erlerobot/PXF2/Documentation/OdroidC1pinout.png

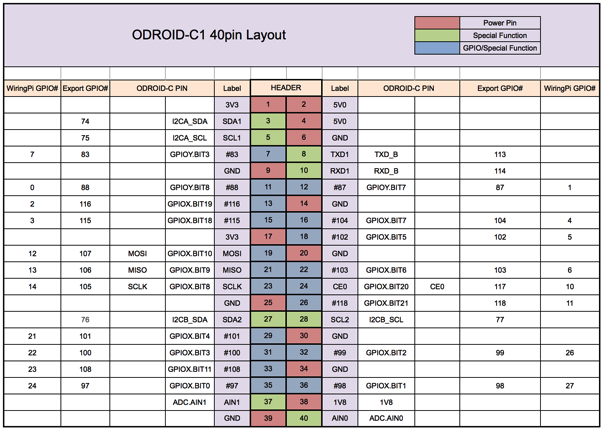
Documentation/OdroidC1pinout.png
