erlerobot/PXF2/Documentation/links.md

HATs intro -> http://www.raspberrypi.org/introducing-raspberry-pi-hats/
