erlerobot/PXF2/Documentation/Rpi2-PXF.png

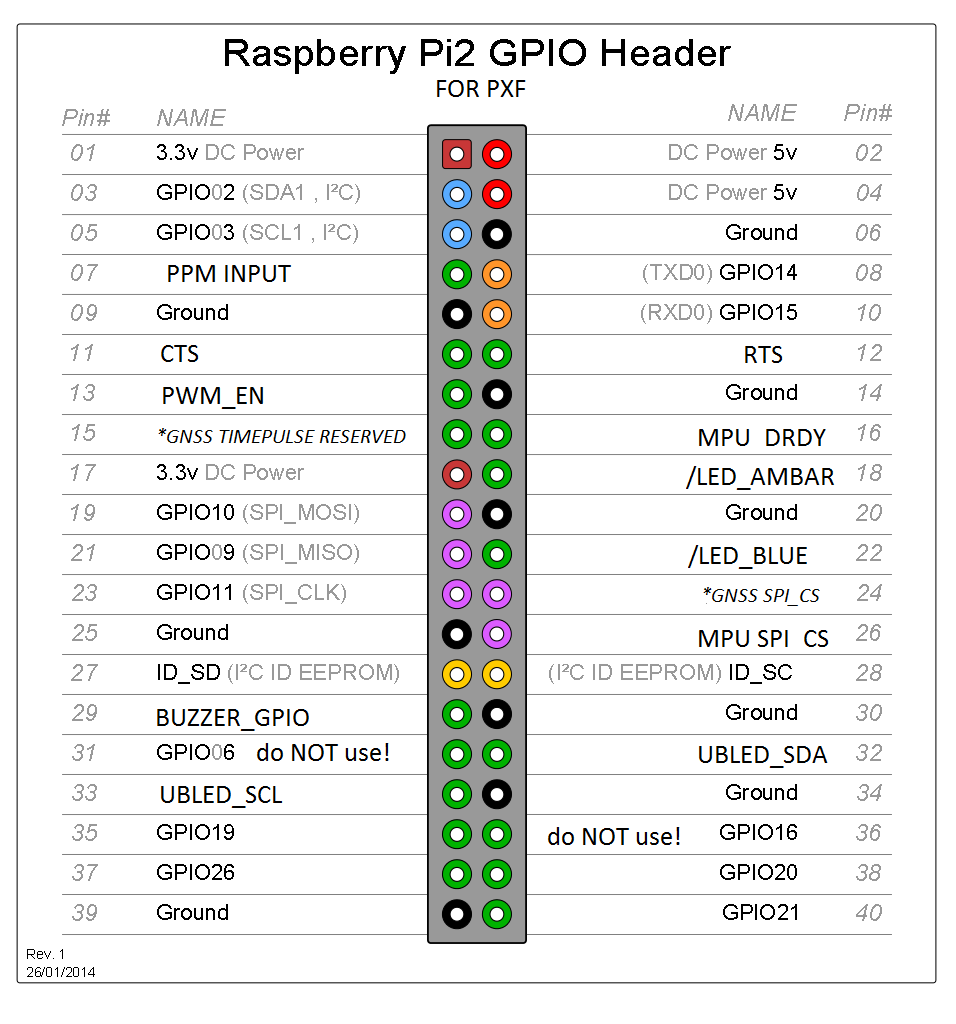
Documentation/Rpi2-PXF.png
