erlerobot/PXF2/(threads)

Thread 1 (2016-01-22):

How big are your hearts I might have found a measurement device.

Irishandfreckled, 2016-01-22:
I'm 35 and for the last 1/3 of my life I was not part of it nor was any Life to be quarryed from the deepest reaches. As a younger man I qualified as a Carpenter. After7 years of magical wood evocation I completed a year long metal multiskils certified "feetac accredited" level 11. I'm sure I don't need to explain to smart well educated souls whereby 10 years evaporated. 2 years ago I promised to never be the victim any longer. I started back rebuilding my workshop, body and mind in that order. Awesome change became a given. I started spending my disposal income on a far healthier hobby. Over the last 18 months I learned in a sort of figure of 8 haha. I started with a mid sized quad w 2 mp to SD.Then I bought similar but made sure it had demolition derby like bumper all round. And 40 spare props. As I research I figure maybe a small cq10 can help along those pilot skills. Boy was it a revelation, a month of daily flying and I had a whole new respect for the game. The bumpers came off and spare parts ordered every battery was a 16th too big to fit internally. Customisation really got the heart racing. I mounted it underneath leaving a perfect spot for a better receiver adding the battery weight on bottom gave it a new co gravity and by pure luck I had a fluck of a flyer
Unbeaten control combined with new found skill and further range,I was hooked all over again since I've built a hex with WiFi fps. Currently I have a goal of building a nano fps, all the design is waiting on the Chinese postal service. Can I ask github for the chance to build some form of multi rotor that has all you need in any situation, be it shows for the collogues or stealing the show at a sister's wedding
Sponsor me with your latest technical technology and techniques and I'll be happy to give my full attention from cad to completed one off. My goal should it happen is a quantum leap inveloped by propellers. Foxyinboston@gmail.com let's take it there together.

Closed 2016-01-23.
