erlerobot/PXF2/PXF_v2.0.brd

## EAGLE design PXF_v2.0.brd (2015-11-10)

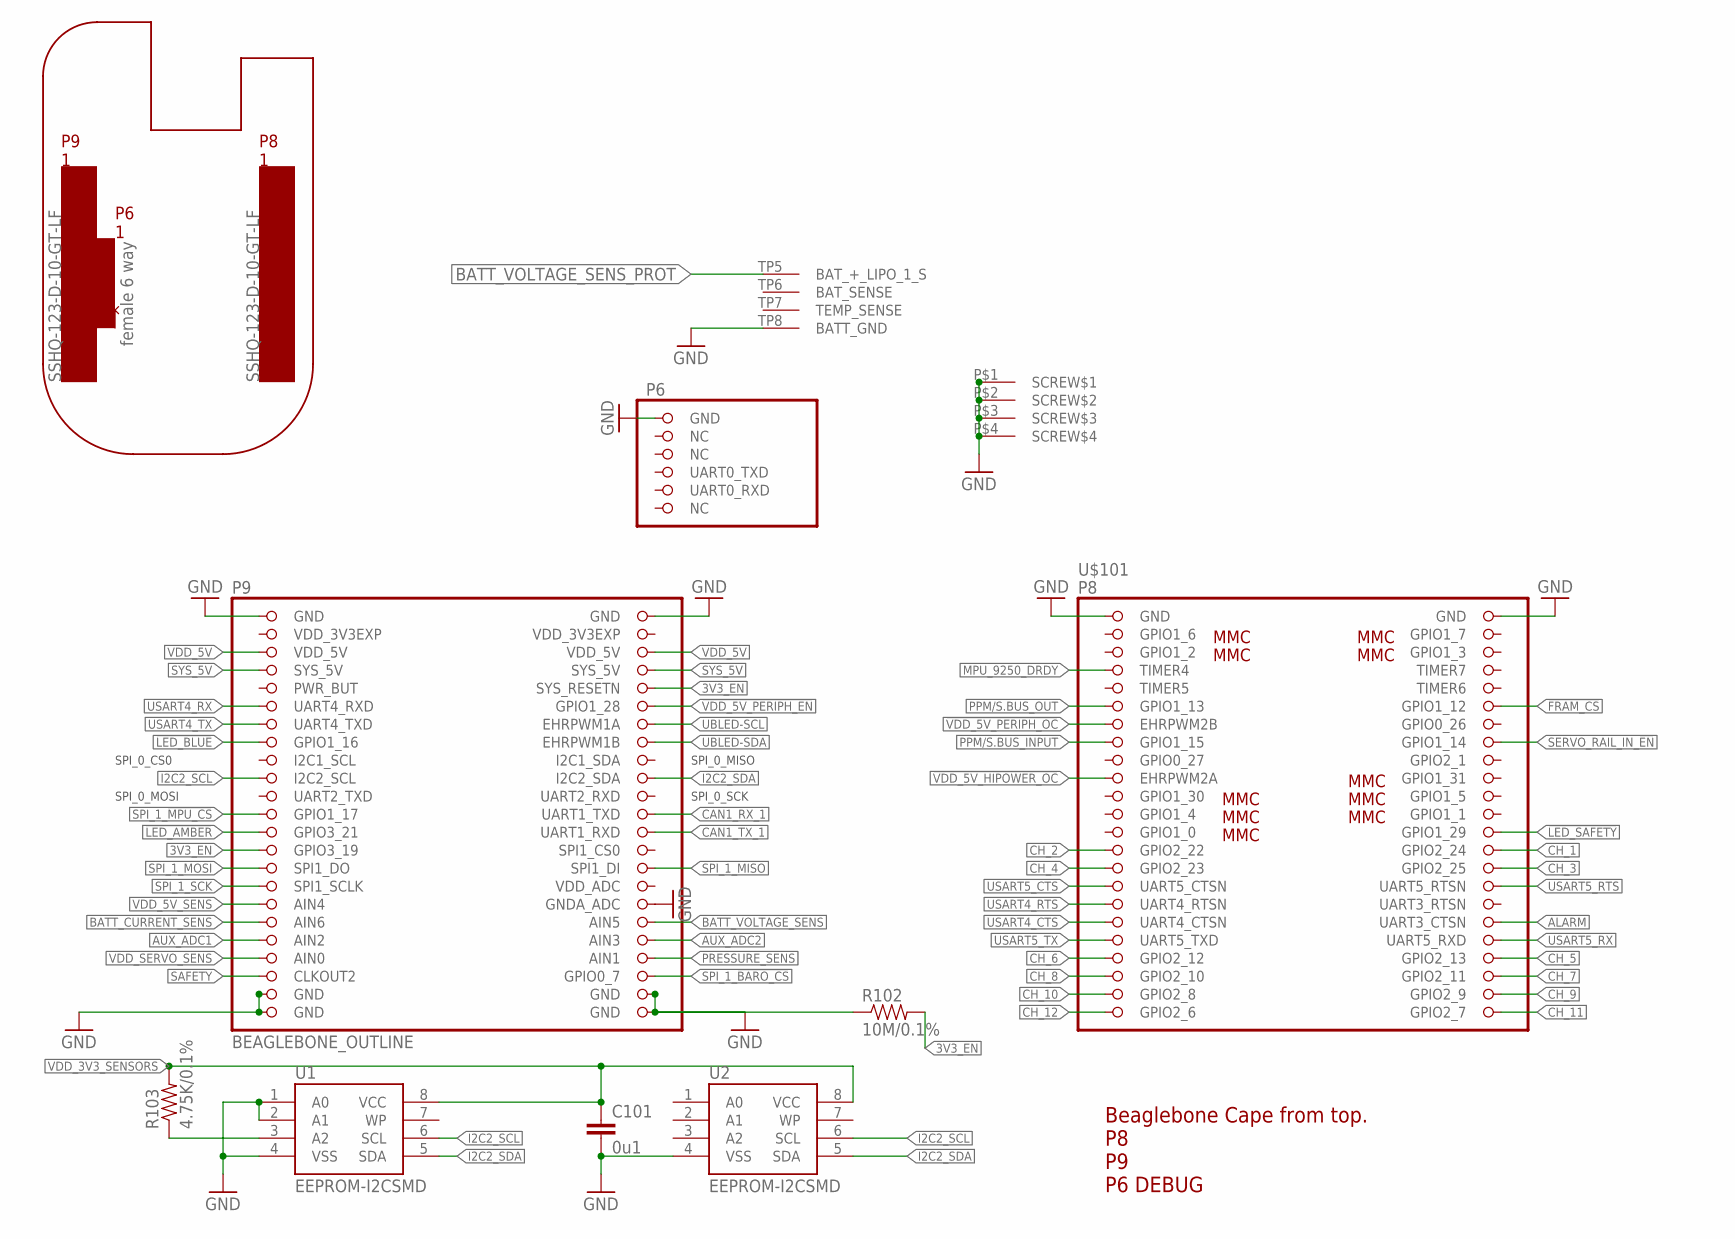
[picture p3: schematic PXF_v2.0.sch, sheet 1]

Parts:
C101: 0u1; 0402-CAP; PARTNO CC0402ZRY5V7BB104
R102: 10M/0.1%; 0402-RES; PARTNO RC0402FR-0710ML
R103: 4.75K/0.1%; 0402-RES; PARTNO RC0402FR-074K75L
U1: EEPROM-I2CSMD; SO08; PARTNO AT24CS32-SSHM
U2: EEPROM-I2CSMD; SO08; PARTNO ATSHA204-SH-DA-TTR-ND
U$101: BEAGLEBONE_OUTLINE; BEAGLEBONE_SHIELD

Connections:
3V3_EN: R102.P$2 (2), U$101.56 (SYS_RESETN), U$101.73 (GPIO3_19); also elsewhere on the board
!FRAM_CS: U$101.12 (GPIO1_12); also elsewhere on the board
!LED_AMBER: U$101.71 (GPIO3_21); also elsewhere on the board
!LED_BLUE: U$101.61 (GPIO1_16); also elsewhere on the board
!LED_SAFETY: U$101.26 (GPIO1_29); also elsewhere on the board
!VDD_5V_HIPOWER_OC: U$101.19 (EHRPWM2A); also elsewhere on the board
!VDD_5V_PERIPH_EN: U$101.58 (GPIO1_28); also elsewhere on the board
!VDD_5V_PERIPH_OC: U$101.13 (EHRPWM2B); also elsewhere on the board
ALARM: U$101.36 (UART3_CTSN); also elsewhere on the board
AUX_ADC1: U$101.83 (AIN2); also elsewhere on the board
AUX_ADC2: U$101.84 (AIN3); also elsewhere on the board
BATT_CURRENT_SENS: U$101.81 (AIN6); also elsewhere on the board
BATT_VOLTAGE_SENS: U$101.82 (AIN5); also elsewhere on the board
BATT_VOLTAGE_SENS_PROT: U$101.TP5 (BAT_+_LIPO_1_S); also elsewhere on the board
CAN1_RX_1: U$101.70 (UART1_TXD); also elsewhere on the board
CAN1_TX_1: U$101.72 (UART1_RXD); also elsewhere on the board
CH_1: U$101.28 (GPIO2_24); also elsewhere on the board
CH_2: U$101.27 (GPIO2_22); also elsewhere on the board
CH_3: U$101.30 (GPIO2_25); also elsewhere on the board
CH_4: U$101.29 (GPIO2_23); also elsewhere on the board
CH_5: U$101.40 (GPIO2_13); also elsewhere on the board
CH_6: U$101.39 (GPIO2_12); also elsewhere on the board
CH_7: U$101.42 (GPIO2_11); also elsewhere on the board
CH_8: U$101.41 (GPIO2_10); also elsewhere on the board
CH_9: U$101.44 (GPIO2_9); also elsewhere on the board
CH_10: U$101.43 (GPIO2_8); also elsewhere on the board
CH_11: U$101.46 (GPIO2_7); also elsewhere on the board
CH_12: U$101.45 (GPIO2_6); also elsewhere on the board
GND: C101.P$2 (2), R102.P$1 (1), U1.1 (A0), U1.2 (A1), U1.4 (VSS), U2.4 (VSS), U$101.1 (GND), U$101.2 (GND), U$101.47 (GND), U$101.48 (GND), U$101.80 (GNDA_ADC), U$101.89 (GND), U$101.90 (GND), U$101.91 (GND), U$101.92 (GND), U$101.93 (GND), U$101.P$1 (SCREW$1), U$101.P$2 (SCREW$2), U$101.P$3 (SCREW$3), U$101.P$4 (SCREW$4), U$101.TP8 (BATT_GND); also elsewhere on the board
I2C2_SCL: U1.6 (SCL), U2.6 (SCL), U$101.65 (I2C2_SCL); also elsewhere on the board
I2C2_SDA: U1.5 (SDA), U2.5 (SDA), U$101.66 (I2C2_SDA); also elsewhere on the board
MPU_9250_DRDY: U$101.7 (TIMER4); also elsewhere on the board
unnamed: R103.P$1 (1), U1.3 (A2)
PPM/S.BUS_INPUT: U$101.15 (GPIO1_15); also elsewhere on the board
PPM/S.BUS_OUT: U$101.11 (GPIO1_13); also elsewhere on the board
PRESSURE_SENS: U$101.86 (AIN1); also elsewhere on the board
SAFETY: U$101.87 (CLKOUT2); also elsewhere on the board
SERVO_RAIL_IN_!EN: U$101.16 (GPIO1_14)
SPI_1_!BARO_CS: U$101.88 (GPIO0_7); also elsewhere on the board
SPI_1_!MPU_CS: U$101.69 (GPIO1_17); also elsewhere on the board
SPI_1_MISO: U$101.76 (SPI1_DI); also elsewhere on the board
SPI_1_MOSI: U$101.75 (SPI1_DO); also elsewhere on the board
SPI_1_SCK: U$101.77 (SPI1_SCLK); also elsewhere on the board
SYS_5V: U$101.53 (SYS_5V), U$101.54 (SYS_5V); also elsewhere on the board
UBLED-SCL: U$101.60 (EHRPWM1A); also elsewhere on the board
UBLED-SDA: U$101.62 (EHRPWM1B); also elsewhere on the board
USART4_CTS: U$101.35 (UART4_CTSN); also elsewhere on the board
USART4_RTS: U$101.33 (UART4_RTSN); also elsewhere on the board
USART4_RX: U$101.57 (UART4_RXD); also elsewhere on the board
USART4_TX: U$101.59 (UART4_TXD); also elsewhere on the board
USART5_CTS: U$101.31 (UART5_CTSN); also elsewhere on the board
USART5_RTS: U$101.32 (UART5_RTSN); also elsewhere on the board
USART5_RX: U$101.38 (UART5_RXD); also elsewhere on the board
USART5_TX: U$101.37 (UART5_TXD); also elsewhere on the board
VDD_3V3EXP: U$101.49 (VDD_3V3EXP), U$101.50 (VDD_3V3EXP)
VDD_3V3_SENSORS: C101.P$1 (1), R103.P$2 (2), U1.8 (VCC), U2.8 (VCC); also elsewhere on the board
VDD_5V: U$101.51 (VDD_5V), U$101.52 (VDD_5V); also elsewhere on the board
VDD_5V_SENS: U$101.79 (AIN4); also elsewhere on the board
VDD_SERVO_SENS: U$101.85 (AIN0); also elsewhere on the board

Notes on the sheet:
Beaglebone Cape from top. P8 P9 P6 DEBUG
SPI_0_CS0
SPI_0_MOSI
SPI_0_MISO
SPI_0_SCK

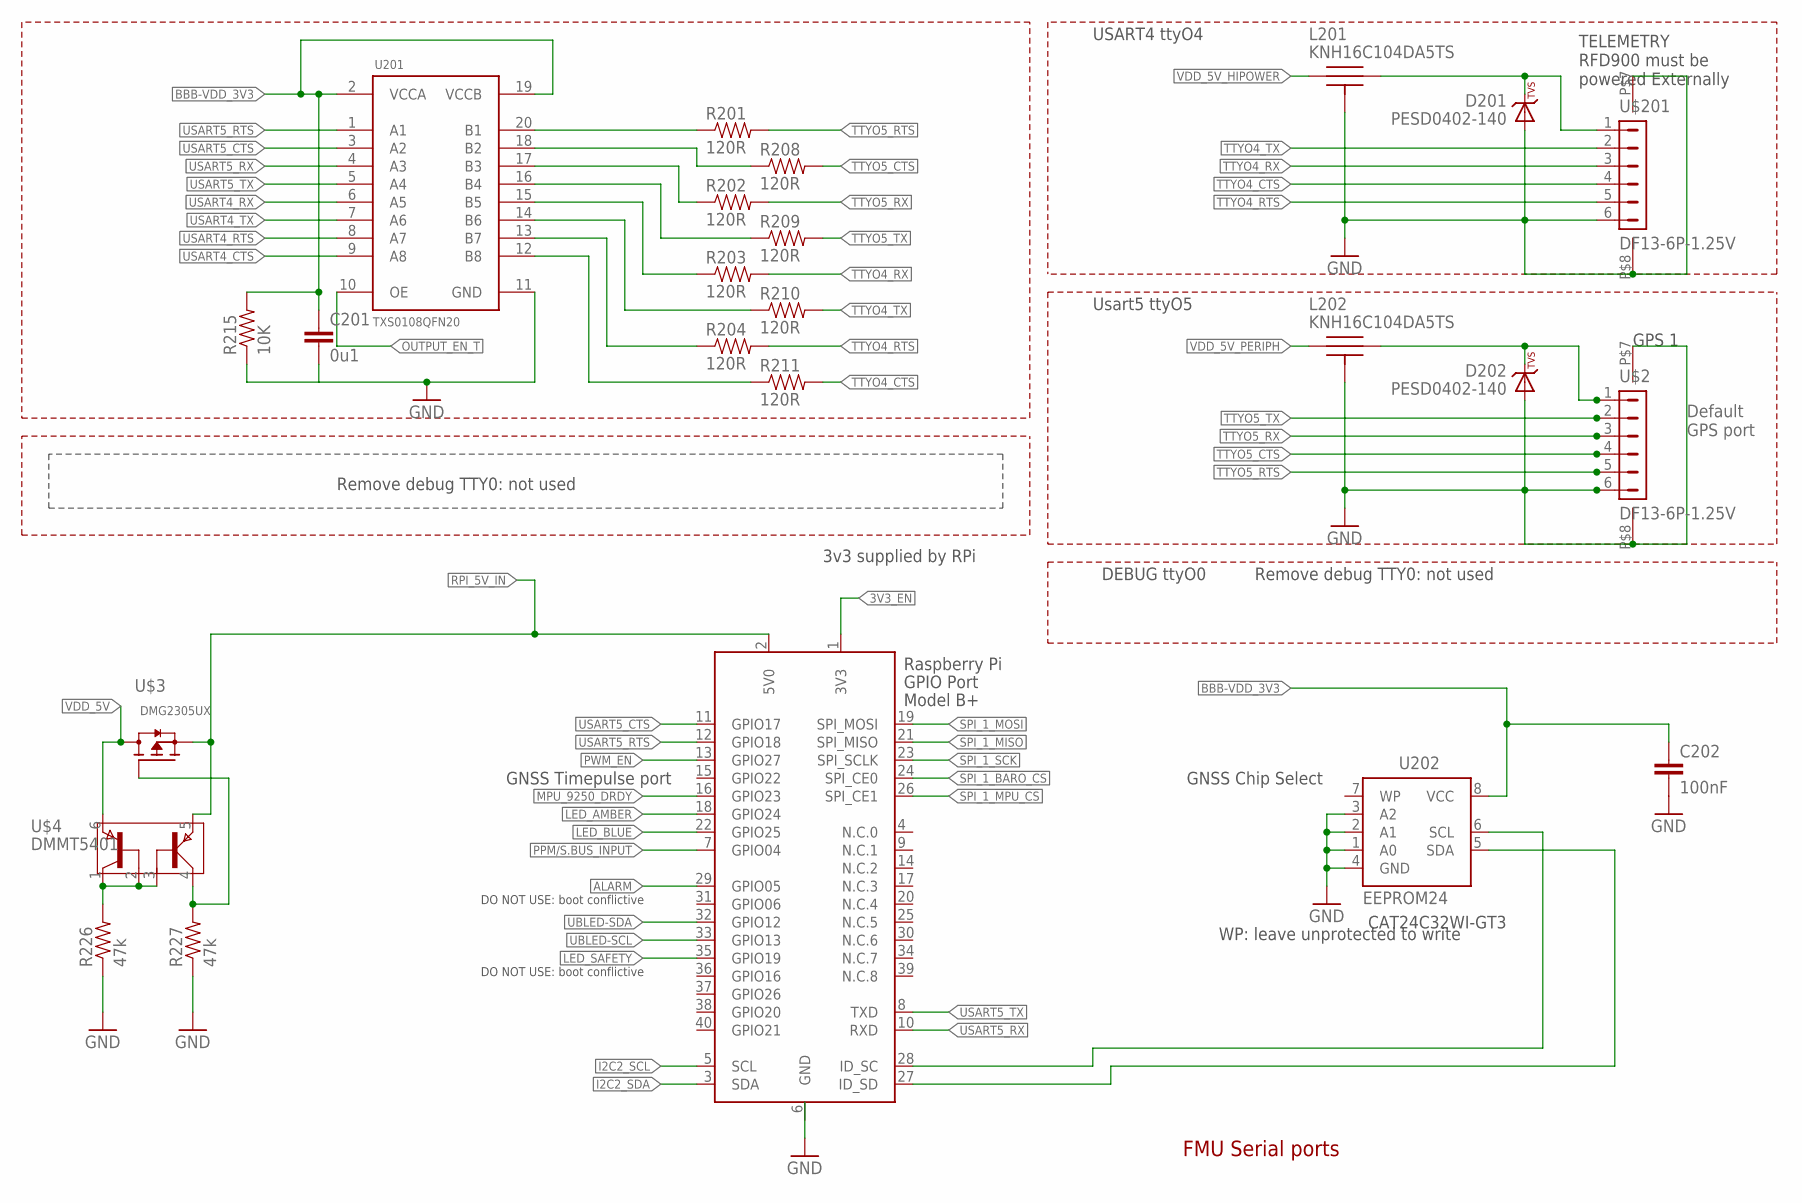
[picture p4: schematic PXF_v2.0.sch, sheet 2]

Parts:
C201: 0u1; 0402-CAP; PARTNO CC0402ZRY5V7BB104
C202: 100nF; 0402-CAP; PARTNO CC0402ZRY5V7BB104
D201, D202: PESD0402-140; 0402-TVS; PARTNO PESD0402-140
L201, L202: KNH16C104DA5TS; KYOCERA-KNH16-DA; PARTNO KNH16C104DA5TS
R201, R202, R203, R204, R208, R209, R210, R211: 120R; 0402-RES; PARTNO RC0402FR-07120RL
R215: 10K; 0402-RES; PARTNO ERA-2AEB103X
R226, R227: 47k; 0402-RES; PARTNO RC0402FR-07120RL
U201: TXS0108QFN20; QFN20-RGY; PARTNO TXS0108ERGYR
U202: EEPROM24; SOIC8
U$2, U$201: DF13-6P-1.25V; DF13C-6P-1.25V; PARTNO DF13C-6P-1.25V(20)
U$3: P-MOSFET; SOT23
U$4: DMMT5401; SOT26
X2: RASPI_BOARD_B+_F; RASPI_BOARD_B+_FULL

Connections:
3V3_EN: X2.1 (3V3); also elsewhere on the board
!LED_AMBER: X2.18 (GPIO24); also elsewhere on the board
!LED_BLUE: X2.22 (GPIO25); also elsewhere on the board
!LED_SAFETY: X2.35 (GPIO19); also elsewhere on the board
ALARM: X2.29 (GPIO05); also elsewhere on the board
BBB-VDD_3V3: C201.P$1 (1), C202.P$1 (1), R215.P$2 (2), U201.2 (VCCA), U201.19 (VCCB), U202.8 (VCC); also elsewhere on the board
GND: C201.P$2 (2), C202.P$2 (2), D201.A, D202.A, L201.P$3, L201.P$4, L201.P$5, L202.P$3, L202.P$4, L202.P$5, R215.P$1 (1), R226.P$1 (1), R227.P$1 (1), U201.11 (GND), U202.1 (A0), U202.2 (A1), U202.3 (A2), U202.4 (GND), U$2.6, U$2.P$7, U$2.P$8, U$201.6, U$201.P$7, U$201.P$8, X2.6 (GND); also elsewhere on the board
I2C2_SCL: X2.5 (SCL); also elsewhere on the board
I2C2_SDA: X2.3 (SDA); also elsewhere on the board
MPU_9250_DRDY: X2.16 (GPIO23); also elsewhere on the board
unnamed: U202.6 (SCL), X2.28 (ID_SC)
unnamed: U202.5 (SDA), X2.27 (ID_SD)
unnamed: D201.C, L201.P$2, U$201.1
unnamed: R226.P$2 (2), U$4.1, U$4.2, U$4.3
unnamed: R227.P$2 (2), U$3.G, U$4.4
unnamed: R208.P$1 (1), U201.18 (B2)
unnamed: R201.P$1 (1), U201.20 (B1)
unnamed: R202.P$1 (1), U201.17 (B3)
unnamed: R209.P$1 (1), U201.16 (B4)
unnamed: R203.P$1 (1), U201.15 (B5)
unnamed: R210.P$1 (1), U201.14 (B6)
unnamed: R204.P$1 (1), U201.13 (B7)
unnamed: R211.P$1 (1), U201.12 (B8)
unnamed: D202.C, L202.P$2, U$2.1
OUTPUT_EN_T: U201.10 (OE); also elsewhere on the board
PPM/S.BUS_INPUT: X2.7 (GPIO04); also elsewhere on the board
PWM_EN: X2.13 (GPIO27); also elsewhere on the board
RPI_5V_IN: U$3.S, U$4.5, X2.2 (5V0); also elsewhere on the board
SPI_1_!BARO_CS: X2.24 (SPI_CE0); also elsewhere on the board
SPI_1_!MPU_CS: X2.26 (SPI_CE1); also elsewhere on the board
SPI_1_MISO: X2.21 (SPI_MISO); also elsewhere on the board
SPI_1_MOSI: X2.19 (SPI_MOSI); also elsewhere on the board
SPI_1_SCK: X2.23 (SPI_SCLK); also elsewhere on the board
TTYO4_CTS: R211.P$2 (2), U$201.4
TTYO4_RTS: R204.P$2 (2), U$201.5
TTYO4_RX: R203.P$2 (2), U$201.3; also elsewhere on the board
TTYO4_TX: R210.P$2 (2), U$201.2; also elsewhere on the board
TTYO5_CTS: R208.P$2 (2), U$2.4
TTYO5_RTS: R201.P$2 (2), U$2.5
TTYO5_RX: R202.P$2 (2), U$2.3; also elsewhere on the board
TTYO5_TX: R209.P$2 (2), U$2.2; also elsewhere on the board
UBLED-SCL: X2.33 (GPIO13); also elsewhere on the board
UBLED-SDA: X2.32 (GPIO12); also elsewhere on the board
USART4_CTS: U201.9 (A8); also elsewhere on the board
USART4_RTS: U201.8 (A7); also elsewhere on the board
USART4_RX: U201.6 (A5); also elsewhere on the board
USART4_TX: U201.7 (A6); also elsewhere on the board
USART5_CTS: U201.3 (A2), X2.11 (GPIO17); also elsewhere on the board
USART5_RTS: U201.1 (A1), X2.12 (GPIO18); also elsewhere on the board
USART5_RX: U201.4 (A3), X2.10 (RXD); also elsewhere on the board
USART5_TX: U201.5 (A4), X2.8 (TXD); also elsewhere on the board
VDD_5V: U$3.D, U$4.6; also elsewhere on the board
VDD_5V_HIPOWER: L201.P$1; also elsewhere on the board
VDD_5V_PERIPH: L202.P$1; also elsewhere on the board

Notes on the sheet:
FMU Serial ports
Usart5 ttyO5
USART4 ttyO4
DEBUG ttyO0
Default GPS port
TELEMETRY RFD900 must be powered Externally
GPS 1
Remove debug TTY0: not used
CAT24C32WI-GT3
3v3 supplied by RPi
GNSS Timepulse port
GNSS Chip Select
DO NOT USE: boot conflictive
WP: leave unprotected to write

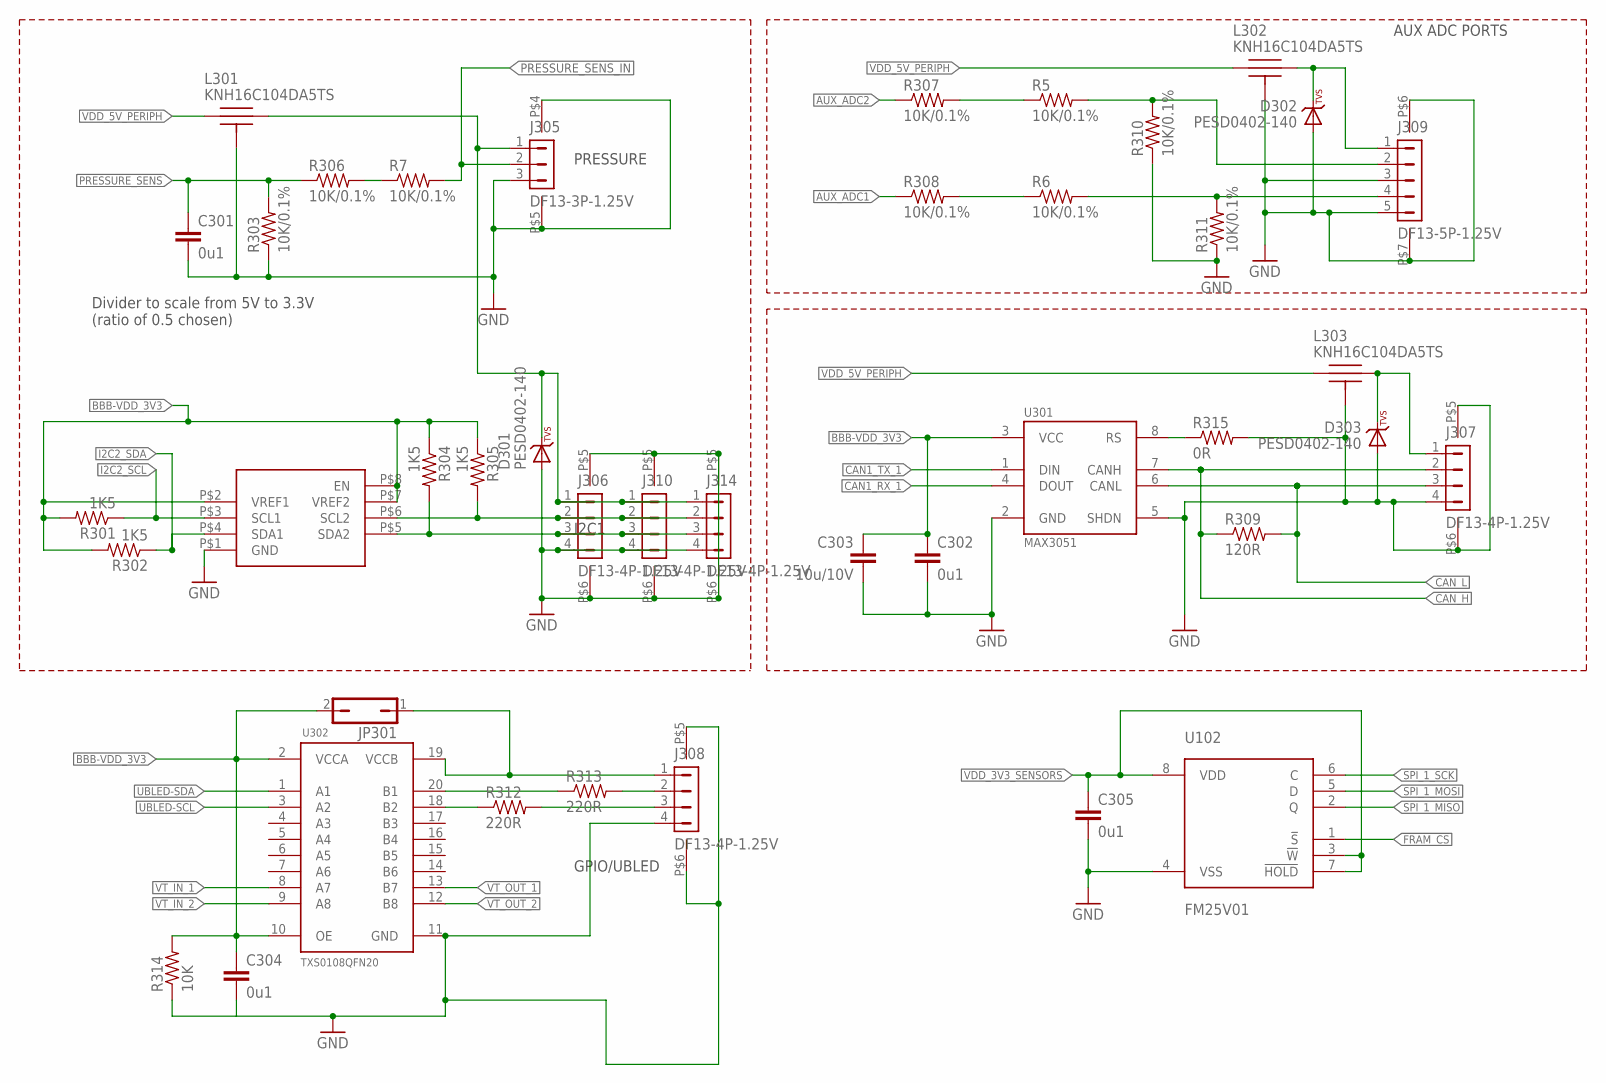
[picture p5: schematic PXF_v2.0.sch, sheet 3]

Parts:
C301, C302, C304, C305: 0u1; 0402-CAP; PARTNO CC0402ZRY5V7BB104
C303: 10u/10V; 0805-CAP; PARTNO CC0805ZKY5V6BB106
D301, D302, D303: PESD0402-140; 0402-TVS; PARTNO PESD0402-140
J305: DF13-3P-1.25V; DF13C-3P-1.25V; PARTNO DF13C-3P-1.25V(20)
J306, J307, J308, J310, J314: DF13-4P-1.25V; DF13C-4P-1.25V; PARTNO DF13C-4P-1.25V(20)
J309: DF13-5P-1.25V; DF13C-5P-1.25V; PARTNO DF13C-5P-1.25V(20)
JP301: JP1Q; JP1; PARTNO 1-87215-0
L301, L302, L303: KNH16C104DA5TS; KYOCERA-KNH16-DA; PARTNO KNH16C104DA5TS
R5, R6, R7, R303, R306, R307, R308, R310, R311: 10K/0.1%; 0402-RES; PARTNO ERA-2AEB103X
R301, R302, R304, R305: 1K5; 0402-RES; PARTNO RC0402FR-071K5L
R309: 120R; 0402-RES; PARTNO RC0402FR-07120RL
R312, R313: 220R; 0402-RES; PARTNO RC0402FR-07220RL
R314: 10K; 0402-RES; PARTNO ERA-2AEB103X
R315: 0R; 0402-RES; PARTNO RC0402FR-070RL
U102: FM25V01; SO08; PARTNO FM25V01-G
U301: MAX3051; SOT23-8; PARTNO MAX3051EKA
U302: TXS0108QFN20; QFN20-RGY; PARTNO TXS0108ERGYR
U304: PCA9603; DCT

Connections:
!FRAM_CS: U102.1 (!S); also elsewhere on the board
AUX_ADC1: R308.P$1 (1); also elsewhere on the board
AUX_ADC2: R307.P$1 (1); also elsewhere on the board
BBB-VDD_3V3: C302.P$1 (1), C303.P$1 (1), C304.P$1 (1), JP301.2, R301.P$2 (2), R302.P$2 (2), R304.P$1 (1), R305.P$1 (1), R314.P$2 (2), U301.3 (VCC), U302.2 (VCCA), U302.10 (OE), U304.P$2 (VREF1), U304.P$7 (VREF2), U304.P$8 (EN); also elsewhere on the board
CAN1_RX_1: U301.4 (DOUT); also elsewhere on the board
CAN1_TX_1: U301.1 (DIN); also elsewhere on the board
CAN_H: J307.2, R309.P$1 (1), U301.7 (CANH); also elsewhere on the board
CAN_L: J307.3, R309.P$2 (2), U301.6 (CANL); also elsewhere on the board
FMU_AUX_ADC1_PROT: J309.4, R6.P$2 (2), R311.P$2 (2)
FMU_AUX_ADC2_PROT: J309.2, R5.P$2 (2), R310.P$2 (2)
GND: C301.P$2 (2), C302.P$2 (2), C303.P$2 (2), C304.P$2 (2), C305.P$2 (2), D301.A, D302.A, D303.A, J305.3, J305.P$4, J305.P$5, J306.4, J306.P$5, J306.P$6, J307.4, J307.P$5, J307.P$6, J308.4, J308.P$5, J308.P$6, J309.3, J309.5, J309.P$6, J309.P$7, J310.4, J310.P$5, J310.P$6, J314.4, J314.P$5, J314.P$6, L301.P$3, L301.P$4, L301.P$5, L302.P$3, L302.P$4, L302.P$5, L303.P$3, L303.P$4, L303.P$5, R303.P$1 (1), R310.P$1 (1), R311.P$1 (1), R314.P$1 (1), R315.P$2 (2), U102.4 (VSS), U301.2 (GND), U301.5 (SHDN), U302.11 (GND), U304.P$1 (GND); also elsewhere on the board
I2C2_SCL: R301.P$1 (1), U304.P$3 (SCL1); also elsewhere on the board
I2C2_SDA: R302.P$1 (1), U304.P$4 (SDA1); also elsewhere on the board
unnamed: R313.P$1 (1), U302.20 (B1)
unnamed: J306.2, J310.2, J314.2, R305.P$2 (2), U304.P$6 (SCL2)
unnamed: J306.3, J310.3, J314.3, R304.P$2 (2), U304.P$5 (SDA2)
unnamed: R312.P$1 (1), U302.18 (B2)
unnamed: D301.C, J305.1, J306.1, J310.1, J314.1, L301.P$2
unnamed: J308.3, R312.P$2 (2)
unnamed: J308.2, R313.P$2 (2)
unnamed: J308.1, JP301.1, U302.19 (VCCB)
unnamed: D303.C, J307.1, L303.P$2
unnamed: R315.P$1 (1), U301.8 (RS)
unnamed: R5.P$1 (1), R307.P$2 (2)
unnamed: R6.P$1 (1), R308.P$2 (2)
unnamed: R7.P$1 (1), R306.P$2 (2)
unnamed: D302.C, J309.1, L302.P$2
PRESSURE_SENS: C301.P$1 (1), R303.P$2 (2), R306.P$1 (1); also elsewhere on the board
PRESSURE_SENS_IN: J305.2, R7.P$2 (2); also elsewhere on the board
SPI_1_MISO: U102.2 (Q); also elsewhere on the board
SPI_1_MOSI: U102.5 (D); also elsewhere on the board
SPI_1_SCK: U102.6 (C); also elsewhere on the board
UBLED-SCL: U302.3 (A2); also elsewhere on the board
UBLED-SDA: U302.1 (A1); also elsewhere on the board
VDD_3V3_SENSORS: C305.P$1 (1), U102.3 (!W), U102.7 (!HOLD), U102.8 (VDD); also elsewhere on the board
VDD_5V_PERIPH: L301.P$1, L302.P$1, L303.P$1; also elsewhere on the board
VT_IN_1: U302.8 (A7); also elsewhere on the board
VT_IN_2: U302.9 (A8); also elsewhere on the board
VT_OUT_1: U302.13 (B7); also elsewhere on the board
VT_OUT_2: U302.12 (B8); also elsewhere on the board

Notes on the sheet:
PRESSURE
I2C1
AUX ADC PORTS
Divider to scale from 5V to 3.3V (ratio of 0.5 chosen)
GPIO/UBLED

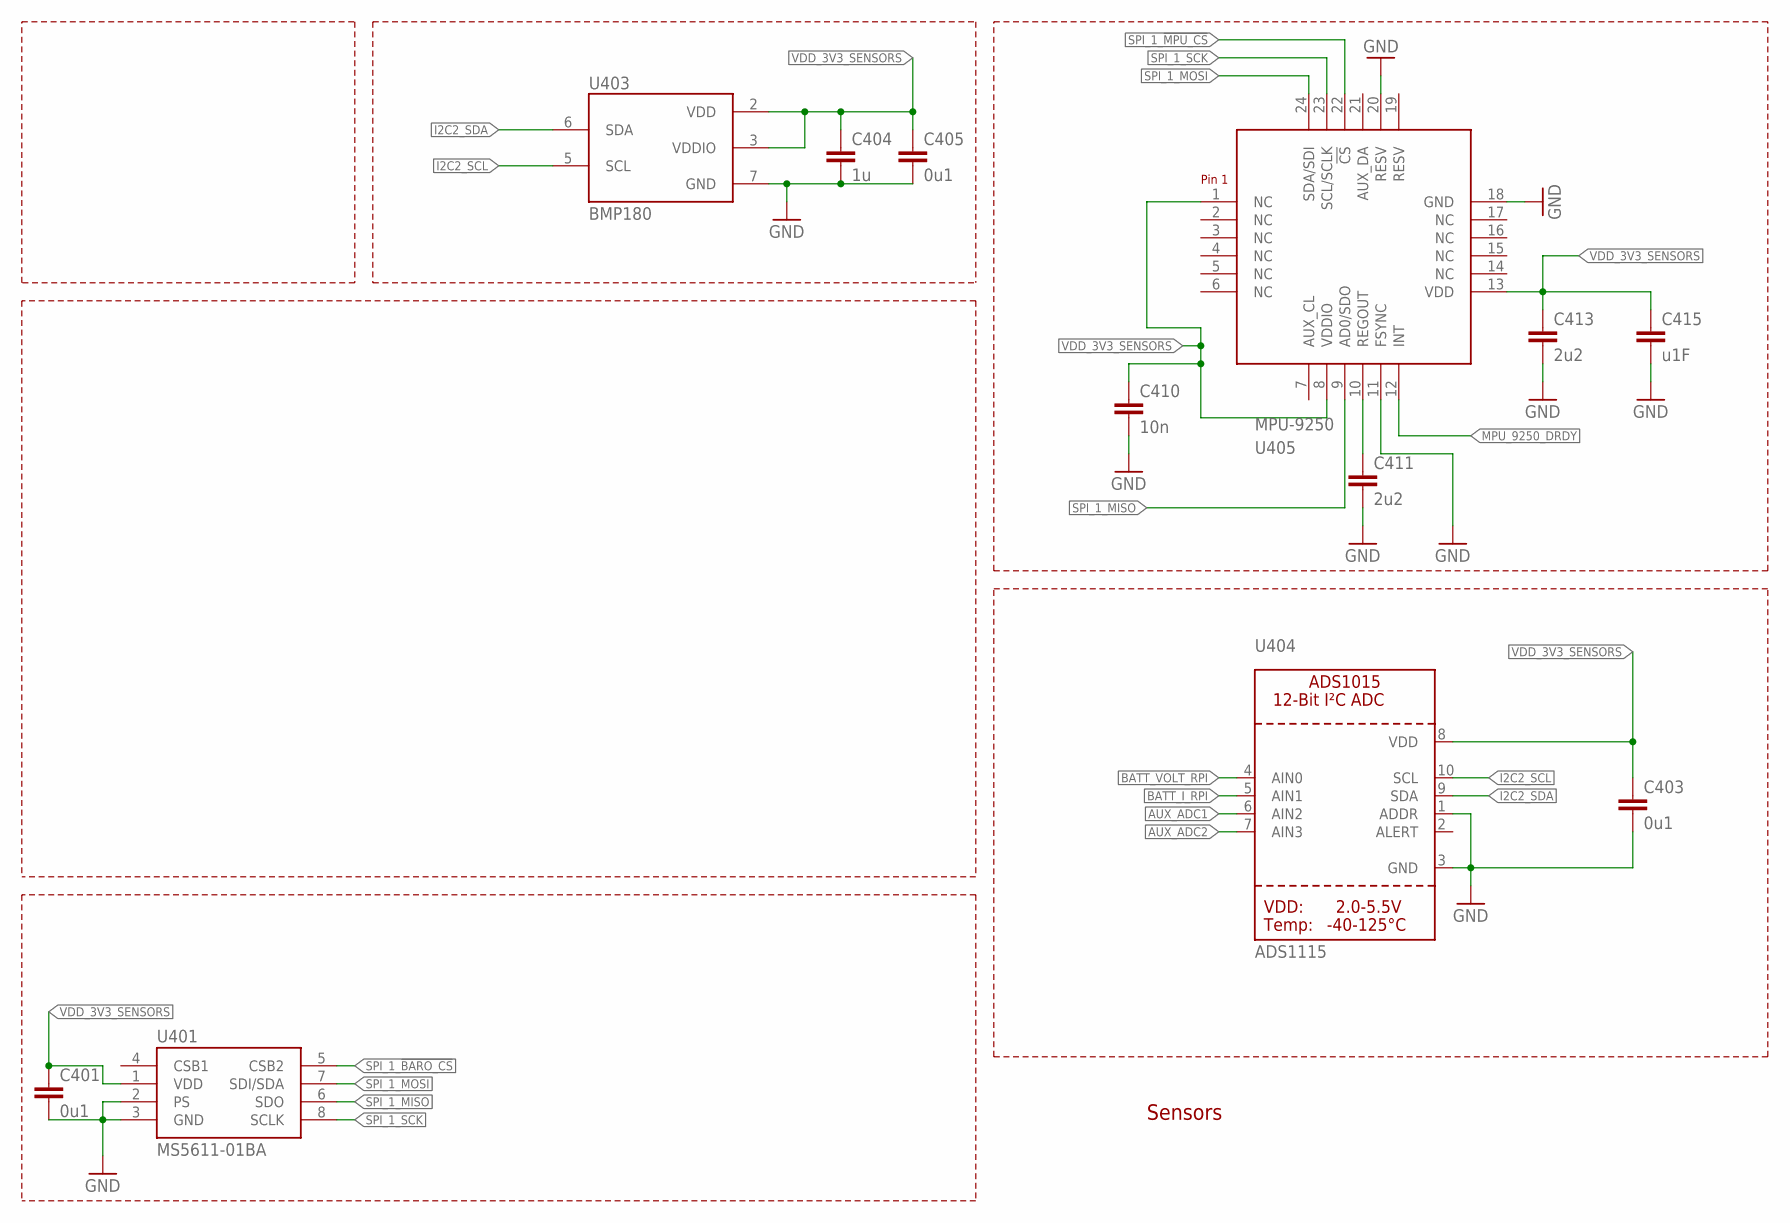
[picture p6: schematic PXF_v2.0.sch, sheet 4]

Parts:
C401, C403, C405: 0u1; 0402-CAP; PARTNO CC0402ZRY5V7BB104
C404: 1u; 0402-CAP; PARTNO CC0402ZRY5V7BB104
C410: 10n; 0603-CAP; PARTNO C0603C103J5RAC7411
C411: 2u2; 0603-CAP; PARTNO C1608X6S1C225K080AC
C413: 2u2; 0603-CAP
C415: u1F; 0402-CAP; PARTNO CC0402ZRY5V7BB104
U401: MS5611-01BA; PARTNO MS5611-01BA
U403: BMP180
U404: ADS1115; MSOP10
U405: MPU-9250; MPU-6500; PARTNO MPU-9250

Connections:
AUX_ADC1: U404.6 (AIN2); also elsewhere on the board
AUX_ADC2: U404.7 (AIN3); also elsewhere on the board
BATT_I_RPI: U404.5 (AIN1); also elsewhere on the board
BATT_VOLT_RPI: U404.4 (AIN0); also elsewhere on the board
GND: C401.P$2 (2), C403.P$2 (2), C404.P$2 (2), C405.P$2 (2), C410.P$2 (2), C411.P$2 (2), C413.P$2 (2), C415.P$2 (2), U401.2 (PS), U401.3 (GND), U403.7 (GND), U404.1 (ADDR), U404.3 (GND), U405.11 (FSYNC), U405.18 (GND), U405.20 (RESV); also elsewhere on the board
I2C2_SCL: U403.5 (SCL), U404.10 (SCL); also elsewhere on the board
I2C2_SDA: U403.6 (SDA), U404.9 (SDA); also elsewhere on the board
MPU_9250_DRDY: U405.12 (INT); also elsewhere on the board
unnamed: C411.P$1 (1), U405.10 (REGOUT)
SPI_1_!BARO_CS: U401.5 (CSB2); also elsewhere on the board
SPI_1_!MPU_CS: U405.22 (!CS); also elsewhere on the board
SPI_1_MISO: U401.6 (SDO), U405.9 (AD0/SDO); also elsewhere on the board
SPI_1_MOSI: U401.7 (SDI/SDA), U405.24 (SDA/SDI); also elsewhere on the board
SPI_1_SCK: U401.8 (SCLK), U405.23 (SCL/SCLK); also elsewhere on the board
VDD_3V3_SENSORS: C401.P$1 (1), C403.P$1 (1), C404.P$1 (1), C405.P$1 (1), C410.P$1 (1), C413.P$1 (1), C415.P$1 (1), U401.1 (VDD), U403.2 (VDD), U403.3 (VDDIO), U404.8 (VDD), U405.1 (NC), U405.8 (VDDIO), U405.13 (VDD); also elsewhere on the board

Notes on the sheet:
Sensors

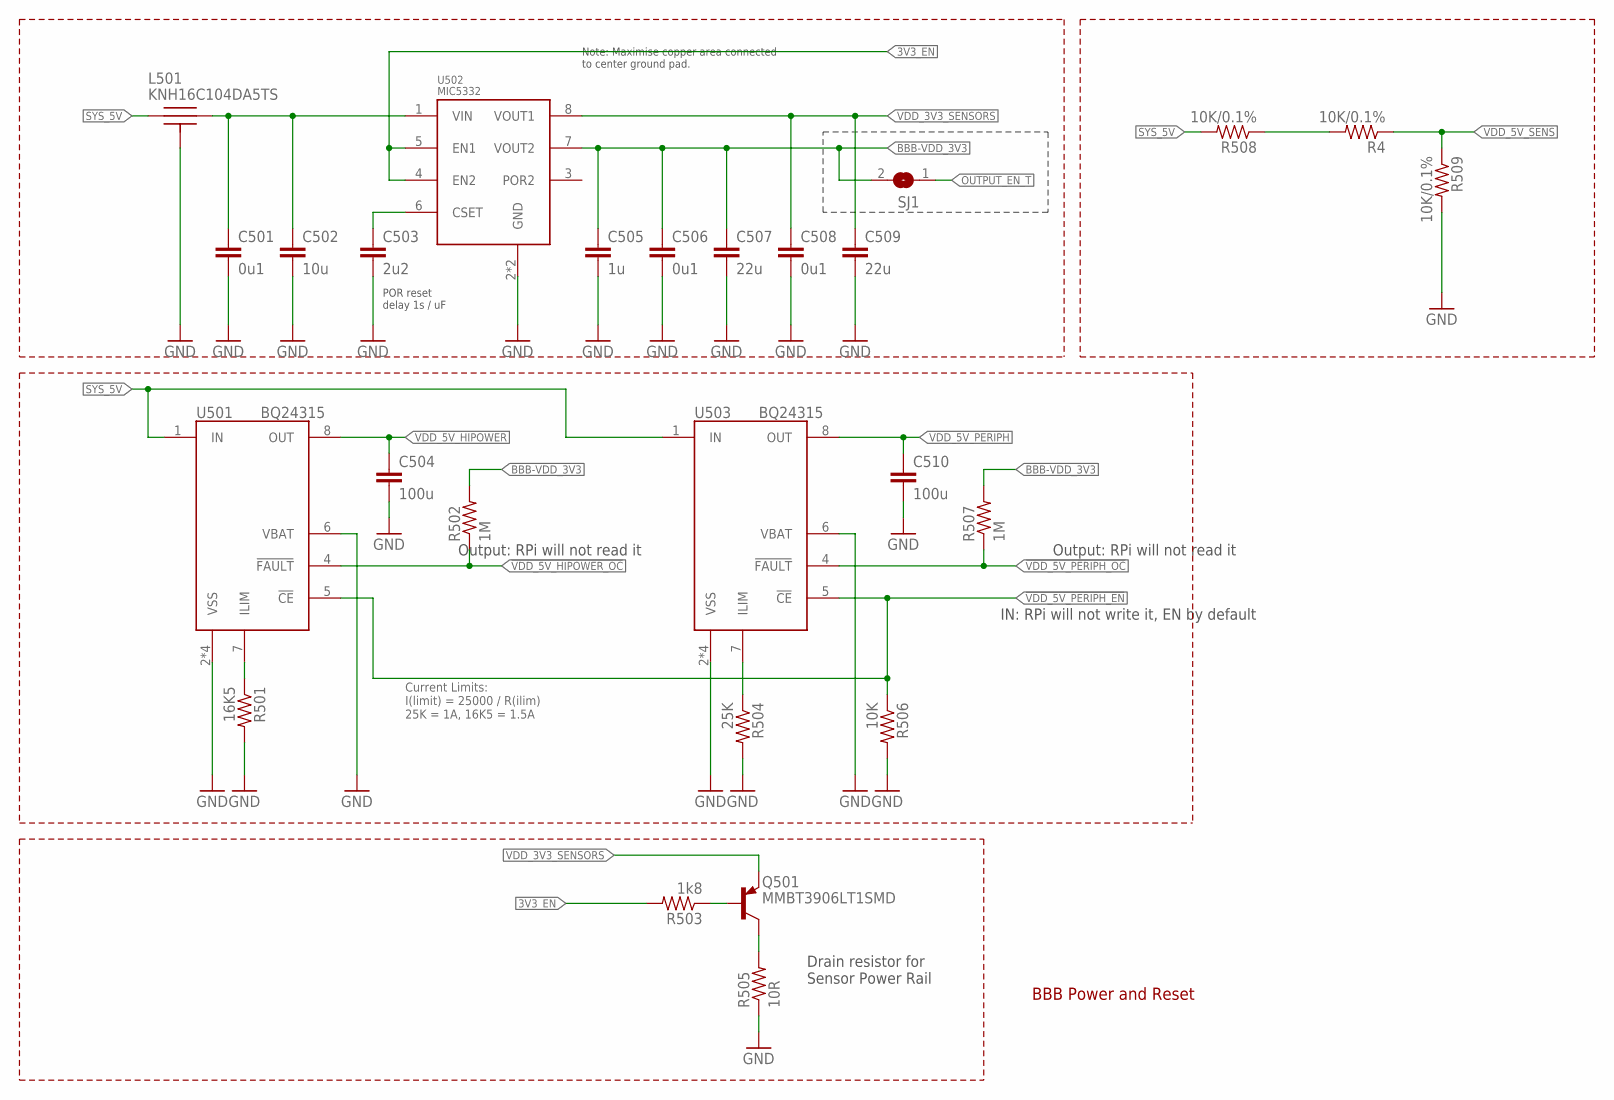
[picture p7: schematic PXF_v2.0.sch, sheet 5]

Parts:
C501, C506, C508: 0u1; 0402-CAP; PARTNO CC0402ZRY5V7BB104
C502: 10u; 0805-CAP; PARTNO C1608X7S0J106M080AC
C503: 2u2; 0603-CAP; PARTNO C1608X6S1C225K080AC
C504, C510: 100u; 1206-CAP; PARTNO C3216X5R1A107M160AC
C505: 1u; 0603-CAP; PARTNO CC0603ZRY5V7BB105
C507, C509: 22u; 0805-CAP; PARTNO CC0805MKX5R5BB226
L501: KNH16C104DA5TS; KYOCERA-KNH16-DA; PARTNO KNH16C104DA5TS
Q501: MMBT3906LT1SMD; SOT23-BEC; PARTNO MMBT3906LT1G
R4, R508, R509: 10K/0.1%; 0402-RES; PARTNO ERA-2AEB103X
R501: 16K5; 0402-RES; PARTNO RMCF0402FT16K5
R502, R507: 1M; 0402-RES; PARTNO MCR01MRTF1004
R503: 1k8; 0402-RES; PARTNO RC0402FR-071K8L
R504: 25K; 0402-RES; PARTNO RMCF0402FT25K5
R505: 10R; 0603-RES; PARTNO RC0402FR-0710RL
R506: 10K; 0402-RES; PARTNO ERA-2AEB103X
SJ1: SOLDERJUMPERCLOSED; SOLDERJUMPER_CLOSEDWIRE
U501, U503: BQ24315; QFN8-DSG; PARTNO BQ24315DSGR
U502: MIC5332; MLF-8-EPAD; PARTNO MIC5332-SSYMT

Connections:
3V3_EN: R503.P$2 (2), U502.4 (EN2), U502.5 (EN1); also elsewhere on the board
!VDD_5V_HIPOWER_OC: R502.P$1 (1), U501.4 (!FAULT); also elsewhere on the board
!VDD_5V_PERIPH_EN: R506.P$1 (1), U501.5 (!CE), U503.5 (!CE); also elsewhere on the board
!VDD_5V_PERIPH_OC: R507.P$1 (1), U503.4 (!FAULT); also elsewhere on the board
BBB-VDD_3V3: C505.P$1 (1), C506.P$1 (1), C507.P$1 (1), R502.P$2 (2), R507.P$2 (2), SJ1.2, U502.7 (VOUT2); also elsewhere on the board
FMU-VDD_5V5: C501.P$1 (1), C502.P$1 (1), L501.P$2, U502.1 (VIN)
GND: C501.P$2 (2), C502.P$2 (2), C503.P$2 (2), C504.P$2 (2), C505.P$2 (2), C506.P$2 (2), C507.P$2 (2), C508.P$2 (2), C509.P$2 (2), C510.P$2 (2), L501.P$3, L501.P$4, L501.P$5, R501.P$2 (2), R504.P$2 (2), R505.1, R506.P$2 (2), R509.P$2 (2), U501.2 (VSS), U501.6 (VBAT), U501.GND (VSS), U501.P$2 (VSS), U501.P$3 (VSS), U502.2 (GND), U502.GND, U503.2 (VSS), U503.6 (VBAT), U503.GND (VSS), U503.P$2 (VSS), U503.P$3 (VSS); also elsewhere on the board
unnamed: C503.P$1 (1), U502.6 (CSET)
unnamed: R504.P$1 (1), U503.7 (ILIM)
unnamed: R4.P$2 (2), R508.P$1 (1)
unnamed: Q501.C, R505.2
unnamed: Q501.B, R503.P$1 (1)
unnamed: R501.P$1 (1), U501.7 (ILIM)
OUTPUT_EN_T: SJ1.1; also elsewhere on the board
SYS_5V: L501.P$1, R508.P$2 (2), U501.1 (IN), U503.1 (IN); also elsewhere on the board
VDD_3V3_SENSORS: C508.P$1 (1), C509.P$1 (1), Q501.E, U502.8 (VOUT1); also elsewhere on the board
VDD_5V_HIPOWER: C504.P$1 (1), U501.8 (OUT); also elsewhere on the board
VDD_5V_PERIPH: C510.P$1 (1), U503.8 (OUT); also elsewhere on the board
VDD_5V_SENS: R4.P$1 (1), R509.P$1 (1); also elsewhere on the board

Notes on the sheet:
BBB Power and Reset
Note: Maximise copper area connected to center ground pad.
POR reset delay 1s / uF
Current Limits: I(limit) = 25000 / R(ilim) 25K = 1A, 16K5 = 1.5A
Drain resistor for Sensor Power Rail
Output: RPi will not read it
IN: RPi will not write it, EN by default

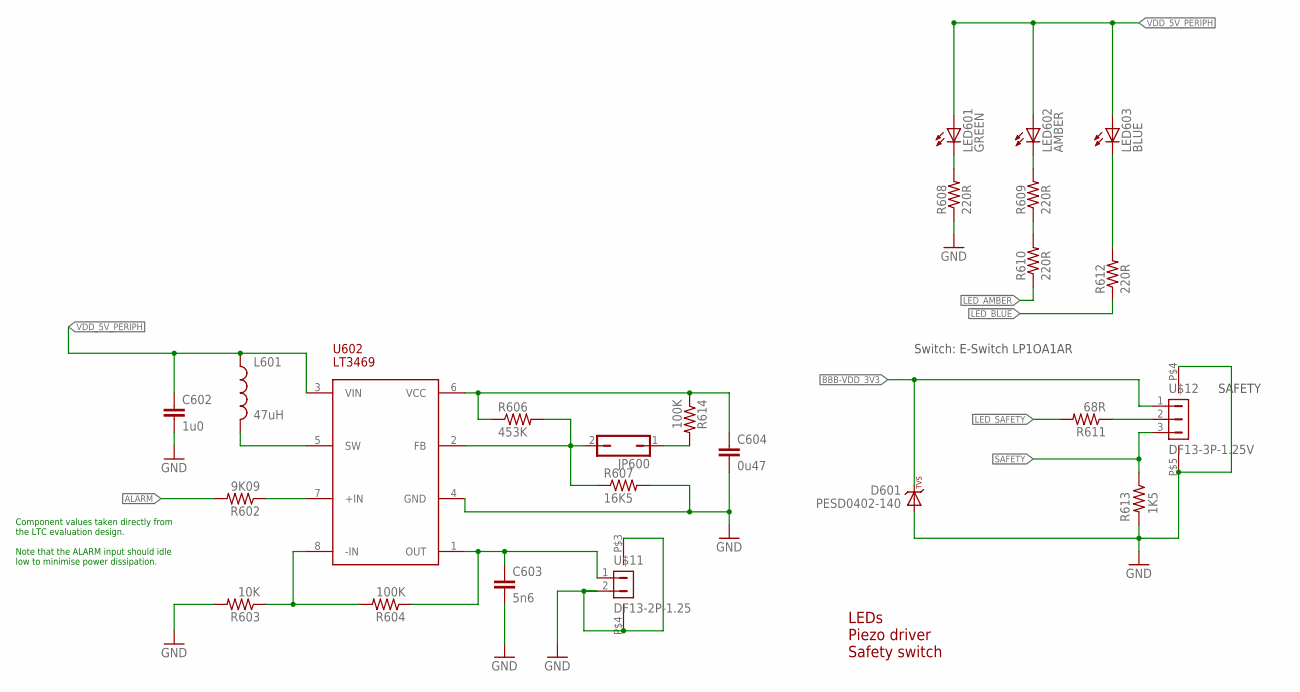
[picture p8: schematic PXF_v2.0.sch, sheet 6]

Parts:
C602: 1u0; 0603-CAP; PARTNO CC0603ZRY5V7BB105
C603: 5n6; 0402-CAP; PARTNO CC0402KRX7R7BB562
C604: 0u47; 0402-CAP; PARTNO C1005X5R1C474K050BC
D601: PESD0402-140; 0402-TVS; PARTNO PESD0402-140
JP600: JP1Q; JP1; PARTNO 1-87215-0
L601: 47uH; 0805-IND; PARTNO MLZ2012M470W
LED601: GREEN; 0603-LED; PARTNO APTD1608CGCK
LED602: AMBER; 0603-LED; PARTNO APTD1608SECK
LED603: BLUE; 0603-LED; PARTNO APTD1608QBC/D
R602: 9K09; 0402-RES; PARTNO RMCF0402FT9K09
R603: 10K; 0402-RES; PARTNO ERA-2AEB103X
R604, R614: 100K; 0402-RES; PARTNO RC0402FR-07100KL
R606: 453K; 0402-RES; PARTNO RMCF0402FT453K
R607: 16K5; 0402-RES; PARTNO RMCF0402FT16K5
R608, R609, R610, R612: 220R; 0402-RES; PARTNO RC0402FR-07220RL
R611: 68R; 0402-RES; PARTNO RC0402FR-0768RL
R613: 1K5; 0402-RES; PARTNO RC0402FR-071K5L
U602: LT3469; SOT23-8; PARTNO LT3469ETS8
U$11: DF13-2P-1.25; DF13C-2P-1.25V; PARTNO DF13C-2P-1.25V(20)
U$12: DF13-3P-1.25V; DF13C-3P-1.25V; PARTNO DF13C-3P-1.25V(20)

Connections:
!LED_AMBER: R610.P$1 (1); also elsewhere on the board
!LED_BLUE: R612.P$1 (1); also elsewhere on the board
!LED_SAFETY: R611.P$2 (2); also elsewhere on the board
ALARM: R602.P$2 (2); also elsewhere on the board
BBB-VDD_3V3: D601.C, U$12.1; also elsewhere on the board
GND: C602.P$2 (2), C603.P$2 (2), C604.P$2 (2), D601.A, R603.P$2 (2), R607.P$2 (2), R608.P$1 (1), R613.P$2 (2), U602.4 (GND), U$11.2, U$11.P$3, U$11.P$4, U$12.P$4, U$12.P$5; also elsewhere on the board
unnamed: LED603.C, R612.P$2 (2)
unnamed: JP600.2, R606.P$2 (2), R607.P$1 (1), U602.2 (FB)
unnamed: R603.P$1 (1), R604.P$2 (2), U602.8 (-IN)
unnamed: C603.P$1 (1), R604.P$1 (1), U602.1 (OUT), U$11.1
unnamed: R602.P$1 (1), U602.7 (+IN)
unnamed: LED601.C, R608.P$2 (2)
unnamed: L601.P$2 (2), U602.5 (SW)
unnamed: C604.P$1 (1), R606.P$1 (1), R614.P$1 (1), U602.6 (VCC)
unnamed: R609.P$1 (1), R610.P$2 (2)
unnamed: LED602.C, R609.P$2 (2)
unnamed: JP600.1, R614.P$2 (2)
unnamed: R611.P$1 (1), U$12.2
SAFETY: R613.P$1 (1), U$12.3; also elsewhere on the board
VDD_5V_PERIPH: C602.P$1 (1), L601.P$1 (1), LED601.A, LED602.A, LED603.A, U602.3 (VIN); also elsewhere on the board

Notes on the sheet:
LEDs Piezo driver Safety switch
Switch: E-Switch LP1OA1AR
SAFETY
Component values taken directly from the LTC evaluation design. Note that the ALARM input should idle low to minimise power dissipation.
