erlerobot/PXF2/PXF_v2.0.brd

## EAGLE design PXF_v2.0.brd (continued)

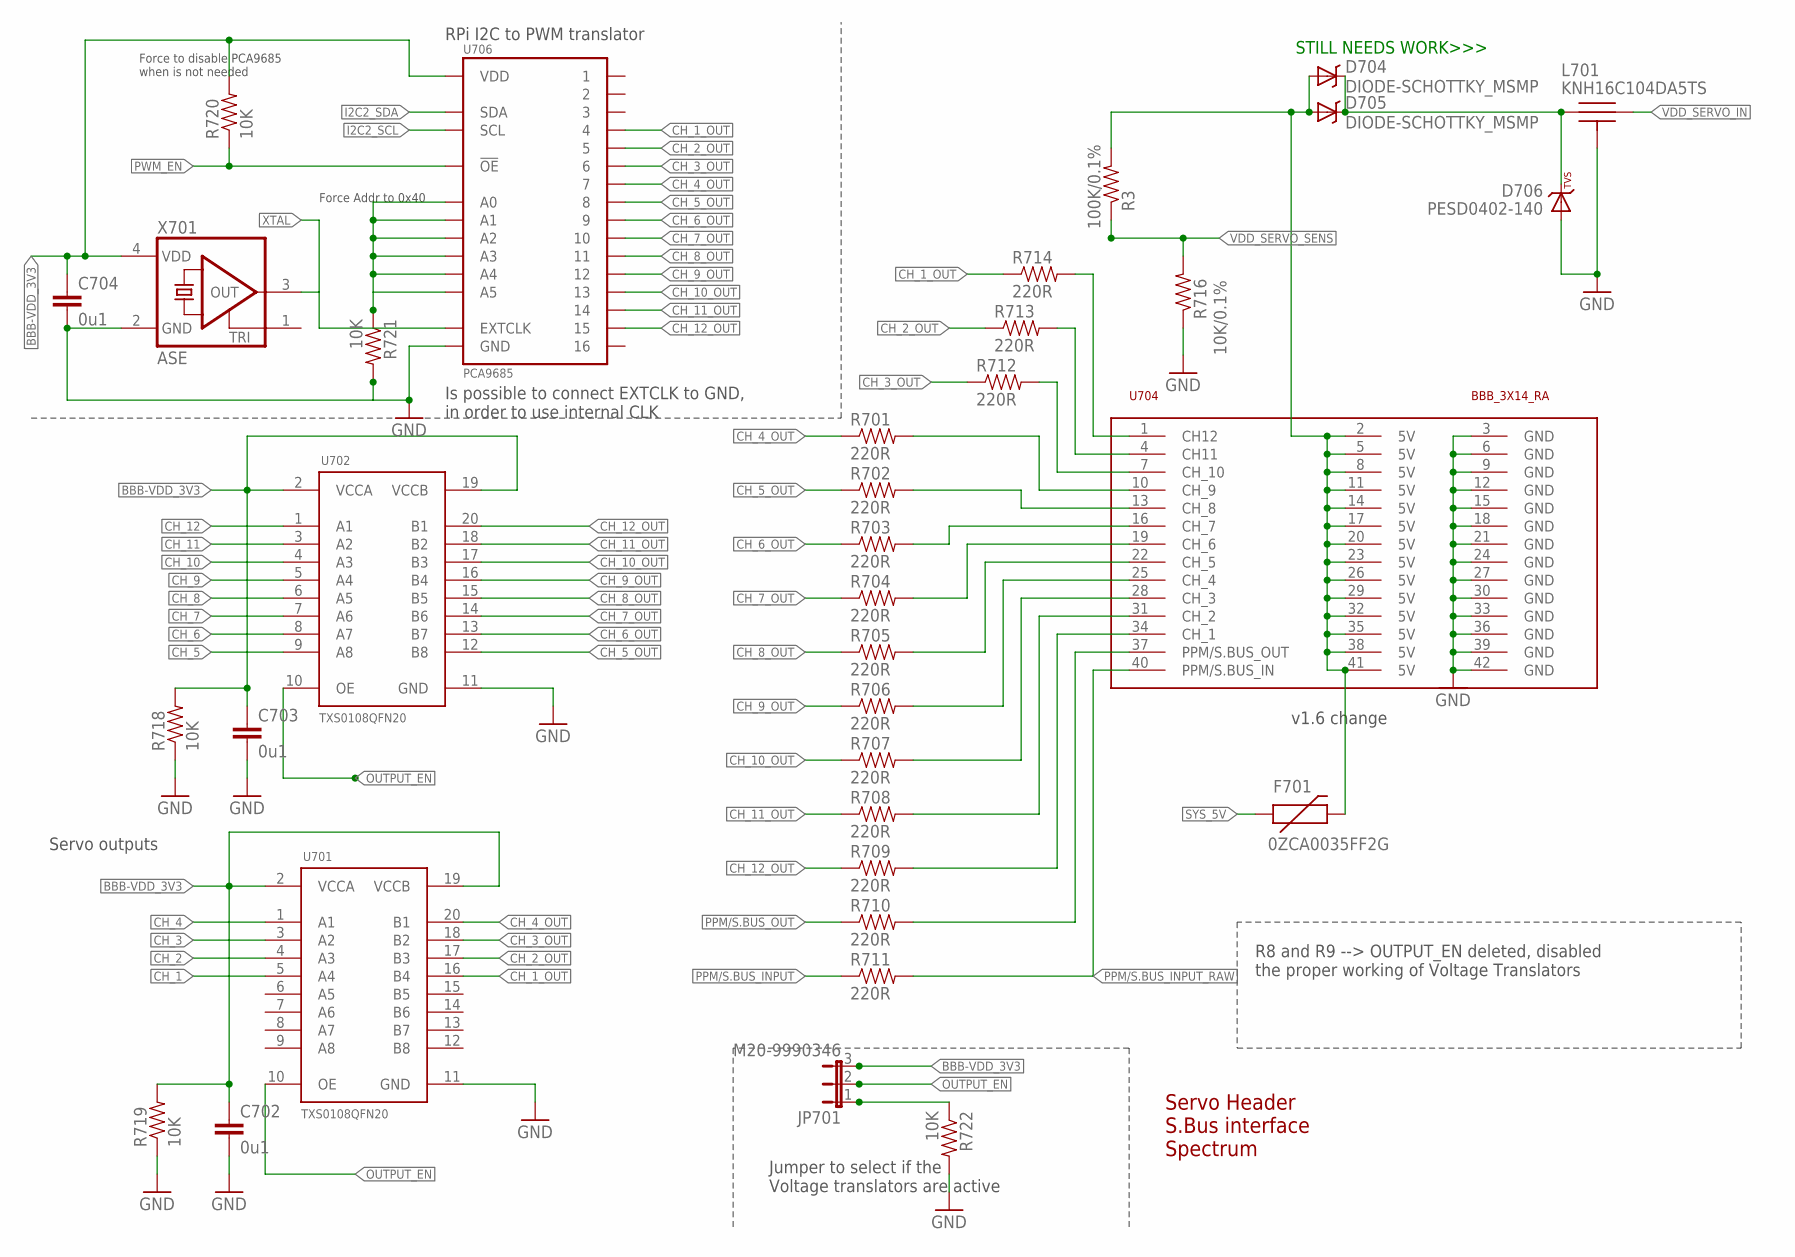
[picture p9: schematic PXF_v2.0.sch, sheet 7]

Parts:
C702, C703, C704: 0u1; 0402-CAP; PARTNO CC0402ZRY5V7BB104
D704, D705: DIODE-SCHOTTKY_MSMP; MICROSMP; PARTNO SS14
D706: PESD0402-140; 0402-TVS; PARTNO PESD0402-140
F701: 0ZCA0035FF2G; PTC-1206; PARTNO 0ZCA0035FF2G
JP701: M20-9990346; JP2
L701: KNH16C104DA5TS; KYOCERA-KNH16-DA; PARTNO KNH16C104DA5TS
R3: 100K/0.1%; 0402-RES; PARTNO ERA-2AEB104X
R701, R702, R703, R704, R705, R706, R707, R708, R709, R710, R711, R712, R713, R714: 220R; 0402-RES; PARTNO RC0402FR-07120RL
R716: 10K/0.1%; 0402-RES; PARTNO ERA-2AEB103X
R718, R719, R720, R721, R722: 10K; 0402-RES; PARTNO ERA-2AEB103X
U701, U702: TXS0108QFN20; QFN20-RGY; PARTNO TXS0108ERGYR
U704: BBB_3X14_RA; 3X14RA; PARTNO 07579
U706: PCA9685; HVQFN28
X701: ASE; MPN ASFL1-24.576MHZ-EC-T

Connections:
BBB-VDD_3V3: C702.P$1 (1), C703.P$1 (1), C704.P$1 (1), JP701.3, R718.P$2 (2), R719.P$2 (2), R720.P$2 (2), U701.2 (VCCA), U701.19 (VCCB), U702.2 (VCCA), U702.19 (VCCB), U706.25 (VDD), X701.4 (VDD); also elsewhere on the board
CH_1: U701.5 (A4); also elsewhere on the board
CH_1_OUT: R714.P$1 (1), U701.16 (B4), U706.6 (4)
CH_2: U701.4 (A3); also elsewhere on the board
CH_2_OUT: R713.P$1 (1), U701.17 (B3), U706.7 (5)
CH_3: U701.3 (A2); also elsewhere on the board
CH_3_OUT: R712.P$1 (1), U701.18 (B2), U706.8 (6)
CH_4: U701.1 (A1); also elsewhere on the board
CH_4_OUT: R701.P$1 (1), U701.20 (B1), U706.9 (7)
CH_5: U702.9 (A8); also elsewhere on the board
CH_5_OUT: R702.P$1 (1), U702.12 (B8), U706.10 (8)
CH_6: U702.8 (A7); also elsewhere on the board
CH_6_OUT: R703.P$1 (1), U702.13 (B7), U706.12 (9)
CH_7: U702.7 (A6); also elsewhere on the board
CH_7_OUT: R704.P$1 (1), U702.14 (B6), U706.13 (10)
CH_8: U702.6 (A5); also elsewhere on the board
CH_8_OUT: R705.P$1 (1), U702.15 (B5), U706.14 (11)
CH_9: U702.5 (A4); also elsewhere on the board
CH_9_OUT: R706.P$1 (1), U702.16 (B4), U706.15 (12)
CH_10: U702.4 (A3); also elsewhere on the board
CH_10_OUT: R707.P$1 (1), U702.17 (B3), U706.16 (13)
CH_11: U702.3 (A2); also elsewhere on the board
CH_11_OUT: R708.P$1 (1), U702.18 (B2), U706.17 (14)
CH_12: U702.1 (A1); also elsewhere on the board
CH_12_OUT: R709.P$1 (1), U702.20 (B1), U706.18 (15)
FMU-CH6-PROT: R708.P$2 (2), U704.31 (CH_2)
GND: C702.P$2 (2), C703.P$2 (2), C704.P$2 (2), D706.A, L701.P$3, L701.P$4, L701.P$5, R716.P$1 (1), R718.P$1 (1), R719.P$1 (1), R721.P$2 (2), R722.P$2 (2), U701.11 (GND), U702.11 (GND), U704.3 (GND), U704.6 (GND), U704.9 (GND), U704.12 (GND), U704.15 (GND), U704.18 (GND), U704.21 (GND), U704.24 (GND), U704.27 (GND), U704.30 (GND), U704.33 (GND), U704.36 (GND), U704.39 (GND), U704.42 (GND), U706.11 (GND), U706.PAD (GND), X701.2 (GND); also elsewhere on the board
I2C2_SCL: U706.23 (SCL); also elsewhere on the board
I2C2_SDA: U706.24 (SDA); also elsewhere on the board
IO-CH1-PROT: R707.P$2 (2), U704.28 (CH_3)
IO-CH8-PROT: R712.P$2 (2), U704.7 (CH_10)
unnamed: R721.P$1 (1), U706.1 (A3), U706.2 (A4), U706.21 (A5), U706.26 (A0), U706.27 (A1), U706.28 (A2)
unnamed: D704.CATHODE (C), D705.CATHODE (C), D706.C, L701.P$1
unnamed: JP701.1, R722.P$1 (1)
unnamed: D704.ANODE (A), D705.ANODE (A), F701.2, R3.P$2 (2), U704.2 (5V), U704.5 (5V), U704.8 (5V), U704.11 (5V), U704.14 (5V), U704.17 (5V), U704.20 (5V), U704.23 (5V), U704.26 (5V), U704.29 (5V), U704.32 (5V), U704.35 (5V), U704.38 (5V), U704.41 (5V)
unnamed: R701.P$2 (2), U704.10 (CH_9)
unnamed: R709.P$2 (2), U704.34 (CH_1)
unnamed: R702.P$2 (2), U704.13 (CH_8)
unnamed: R703.P$2 (2), U704.16 (CH_7)
unnamed: R704.P$2 (2), U704.19 (CH_6)
unnamed: R705.P$2 (2), U704.22 (CH_5)
unnamed: R706.P$2 (2), U704.25 (CH_4)
unnamed: R710.P$2 (2), U704.37 (PPM/S.BUS_OUT)
unnamed: R713.P$2 (2), U704.4 (CH11)
OUTPUT_EN: JP701.2, U701.10 (OE), U702.10 (OE); also elsewhere on the board
PPM-SBUS-PROT: R714.P$2 (2), U704.1 (CH12)
PPM/S.BUS_INPUT: R711.P$1 (1); also elsewhere on the board
PPM/S.BUS_INPUT_RAW: R711.P$2 (2), U704.40 (PPM/S.BUS_IN); also elsewhere on the board
PPM/S.BUS_OUT: R710.P$1 (1); also elsewhere on the board
PWM_EN: R720.P$1 (1), U706.20 (!OE); also elsewhere on the board
SYS_5V: F701.1; also elsewhere on the board
VDD_SERVO_IN: L701.P$2
VDD_SERVO_SENS: R3.P$1 (1), R716.P$2 (2); also elsewhere on the board
XTAL: U706.22 (EXTCLK), X701.3 (OUT); also elsewhere on the board

Notes on the sheet:
Servo Header S.Bus interface Spectrum
Servo outputs
STILL NEEDS WORK>>>
v1.6 change
R8 and R9 --> OUTPUT_EN deleted, disabled the proper working of Voltage Translators
RPi I2C to PWM translator
Force Addr to 0x40
Force to disable PCA9685 when is not needed
Jumper to select if the Voltage translators are active
Is possible to connect EXTCLK to GND, in order to use internal CLK

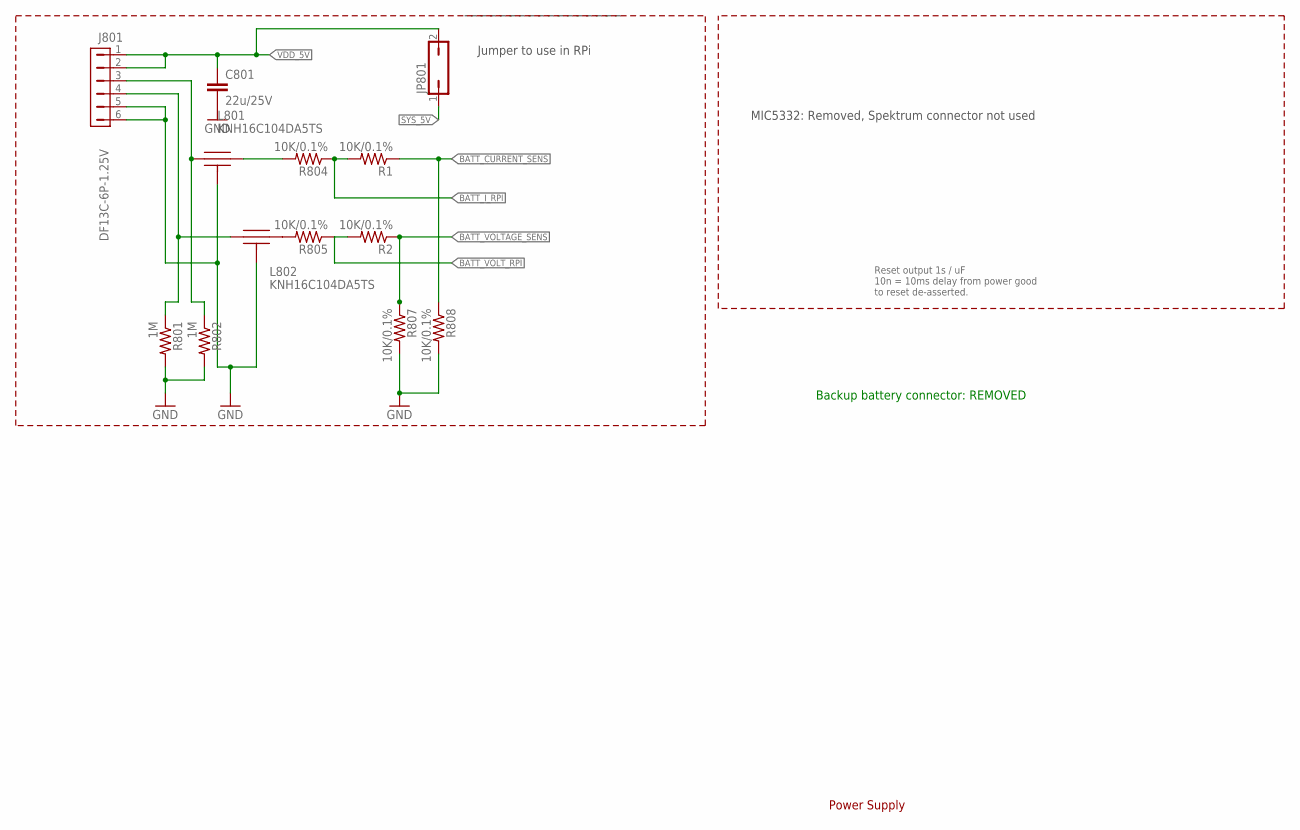
[picture p10: schematic PXF_v2.0.sch, sheet 8]

Parts:
C801: 22u/25V; 0805-CAP; PARTNO CL21A226MAQNNNE
J801: DF13C-6P-1.25V; PARTNO DF13C-6P-1.25V(20)
JP801: JP1Q; JP1; PARTNO 1-87215-0
L801, L802: KNH16C104DA5TS; KYOCERA-KNH16-DA; PARTNO KNH16C104DA5TS
R1, R2, R804, R805, R807, R808: 10K/0.1%; 0402-RES; PARTNO ERA-2AEB103X
R801, R802: 1M; 0402-RES; PARTNO RC0402FR-071ML

Connections:
BATT_CURRENT_SENS: R1.P$1 (1), R808.P$1 (1); also elsewhere on the board
BATT_CURRENT_SENS_PROT: J801.3, L801.P$1, R802.P$1 (1)
BATT_I_RPI: R1.P$2 (2), R804.P$1 (1); also elsewhere on the board
BATT_VOLTAGE_SENS: R2.P$1 (1), R807.P$1 (1); also elsewhere on the board
BATT_VOLTAGE_SENS_PROT: J801.4, L802.P$1, R801.P$1 (1); also elsewhere on the board
BATT_VOLT_RPI: R2.P$2 (2), R805.P$1 (1); also elsewhere on the board
GND: C801.P$2 (2), J801.5, J801.6, L801.P$3, L801.P$4, L801.P$5, L802.P$3, L802.P$4, L802.P$5, R801.P$2 (2), R802.P$2 (2), R807.P$2 (2), R808.P$2 (2); also elsewhere on the board
unnamed: L802.P$2, R805.P$2 (2)
unnamed: L801.P$2, R804.P$2 (2)
SYS_5V: JP801.1; also elsewhere on the board
VDD_5V: C801.P$1 (1), J801.1, J801.2, JP801.2; also elsewhere on the board

Notes on the sheet:
Power Supply
Reset output 1s / uF 10n = 10ms delay from power good to reset de-asserted.
Backup battery connector: REMOVED
MIC5332: Removed, Spektrum connector not used
Jumper to use in RPi

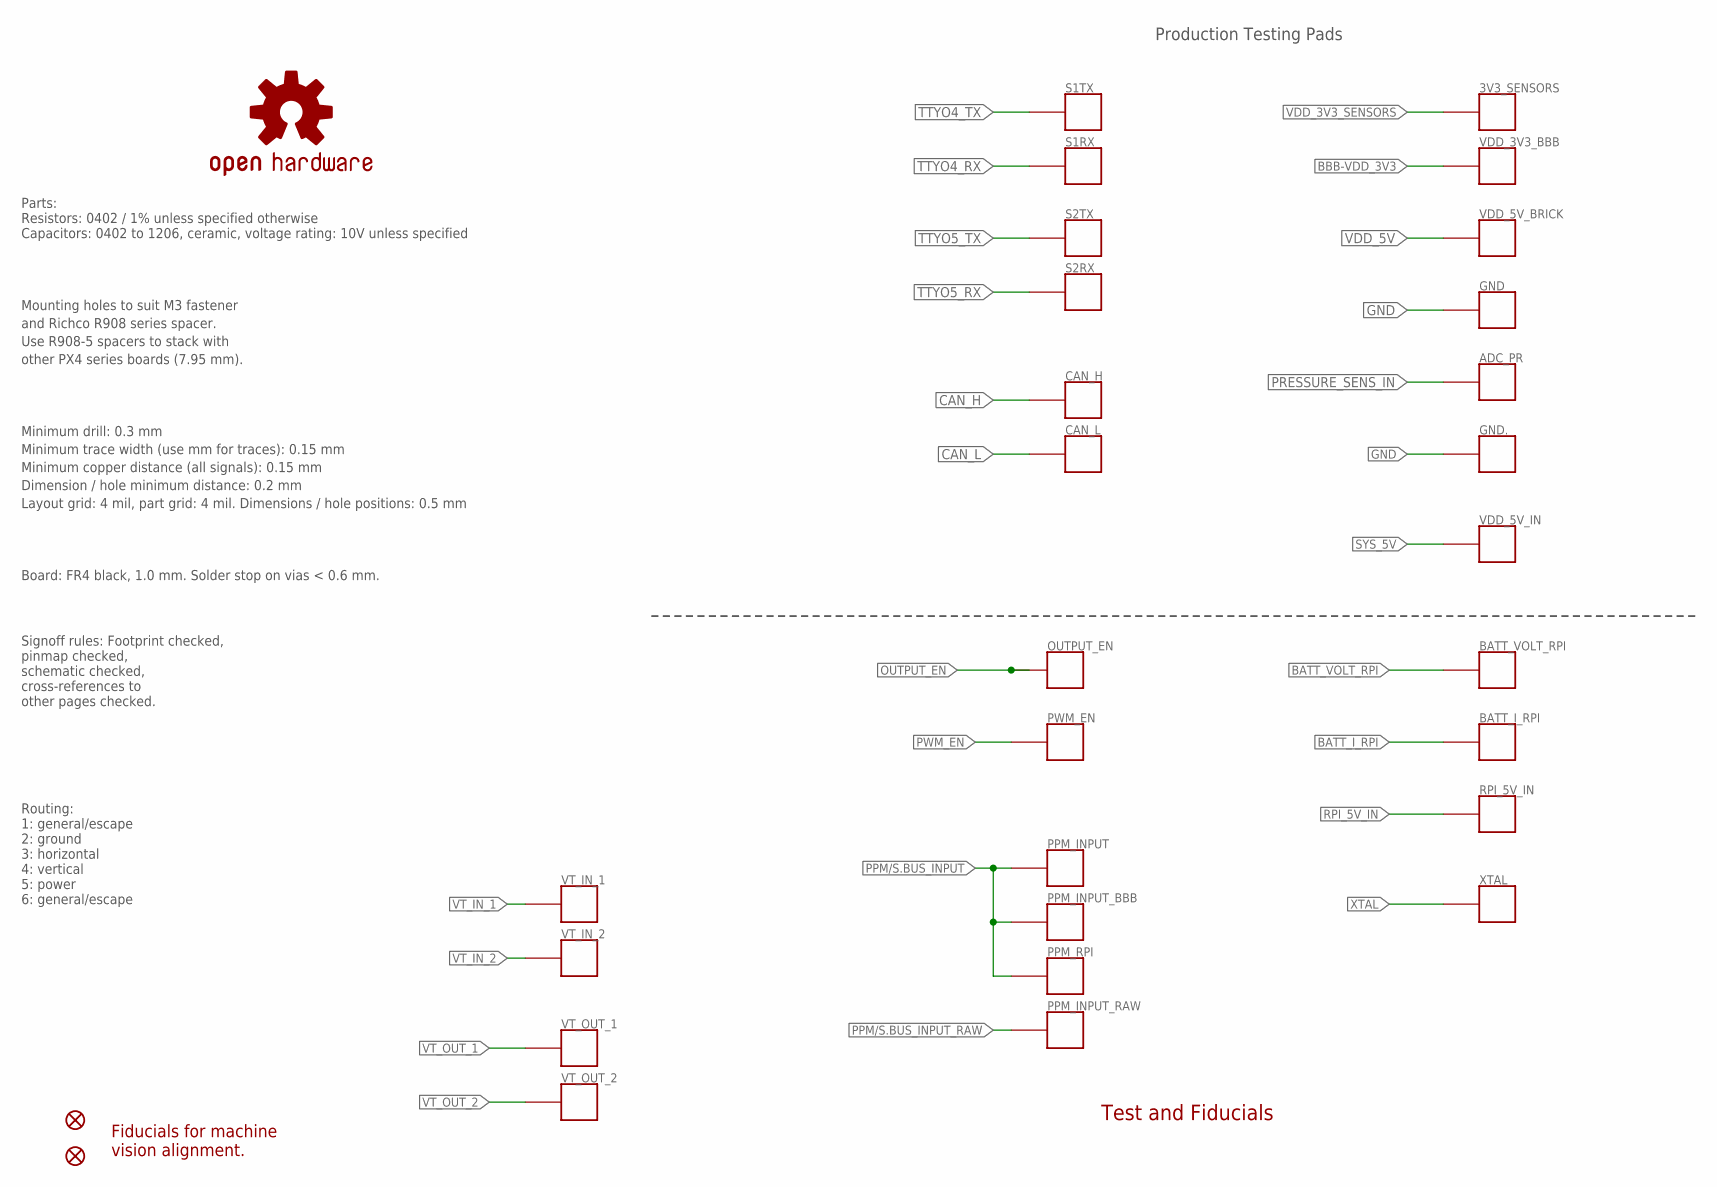
[picture p11: schematic PXF_v2.0.sch, sheet 9]

Parts:
3V3_SENSORS: PAD.04; PAD.04X.04; PARTNO *
ADC_PR: PAD.04; PAD.04X.04; PARTNO *
BATT_I_RPI: PAD.04; PAD.04X.04; PARTNO *
BATT_VOLT_RPI: PAD.04; PAD.04X.04; PARTNO *
CAN_H: PAD.04; PAD.04X.04; PARTNO *
CAN_L: PAD.04; PAD.04X.04; PARTNO *
GND, GND.: PAD.04; PAD.04X.04; PARTNO *
JP901, JP902: FIDUCIAL1.5X3; FIDUCIAL-1.5X3; PARTNO *
OSHW_LOGO: OSHW-LOGOS; OSHW-LOGO-S; PARTNO *
OUTPUT_EN: PAD.04; PAD.04X.04; PARTNO *
PPM_INPUT: PAD.04; PAD.04X.04; PARTNO *
PPM_INPUT_BBB: PAD.04; PAD.04X.04; PARTNO *
PPM_INPUT_RAW: PAD.04; PAD.04X.04; PARTNO *
PPM_RPI: PAD.04; PAD.04X.04; PARTNO *
PWM_EN: PAD.04; PAD.04X.04; PARTNO *
RPI_5V_IN: PAD.04; PAD.04X.04; PARTNO *
S1RX, S1TX, S2RX, S2TX: PAD.04; PAD.04X.04; PARTNO *
VDD_3V3_BBB, VDD_5V_BRICK, VDD_5V_IN: PAD.04; PAD.04X.04; PARTNO *
VT_IN_1, VT_IN_2: PAD.04; PAD.04X.04; PARTNO *
VT_OUT_1, VT_OUT_2: PAD.04; PAD.04X.04; PARTNO *
XTAL: PAD.04; PAD.04X.04; PARTNO *

Connections:
BATT_I_RPI: BATT_I_RPI.P$1; also elsewhere on the board
BATT_VOLT_RPI: BATT_VOLT_RPI.P$1; also elsewhere on the board
BBB-VDD_3V3: VDD_3V3_BBB.P$1; also elsewhere on the board
CAN_H: CAN_H.P$1; also elsewhere on the board
CAN_L: CAN_L.P$1; also elsewhere on the board
GND: GND.P$1, GND..P$1; also elsewhere on the board
OUTPUT_EN: OUTPUT_EN.P$1; also elsewhere on the board
PPM/S.BUS_INPUT: PPM_INPUT.P$1, PPM_INPUT_BBB.P$1, PPM_RPI.P$1; also elsewhere on the board
PPM/S.BUS_INPUT_RAW: PPM_INPUT_RAW.P$1; also elsewhere on the board
PRESSURE_SENS_IN: ADC_PR.P$1; also elsewhere on the board
PWM_EN: PWM_EN.P$1; also elsewhere on the board
RPI_5V_IN: RPI_5V_IN.P$1; also elsewhere on the board
SYS_5V: VDD_5V_IN.P$1; also elsewhere on the board
TTYO4_RX: S1RX.P$1; also elsewhere on the board
TTYO4_TX: S1TX.P$1; also elsewhere on the board
TTYO5_RX: S2RX.P$1; also elsewhere on the board
TTYO5_TX: S2TX.P$1; also elsewhere on the board
VDD_3V3_SENSORS: 3V3_SENSORS.P$1; also elsewhere on the board
VDD_5V: VDD_5V_BRICK.P$1; also elsewhere on the board
VT_IN_1: VT_IN_1.P$1; also elsewhere on the board
VT_IN_2: VT_IN_2.P$1; also elsewhere on the board
VT_OUT_1: VT_OUT_1.P$1; also elsewhere on the board
VT_OUT_2: VT_OUT_2.P$1; also elsewhere on the board
XTAL: XTAL.P$1; also elsewhere on the board

Notes on the sheet:
Mounting holes to suit M3 fastener
and Richco R908 series spacer.
Use R908-5 spacers to stack with
other PX4 series boards (7.95 mm).
Production Testing Pads
Test and Fiducials
Minimum drill: 0.3 mm
Minimum trace width (use mm for traces): 0.15 mm
Minimum copper distance (all signals): 0.15 mm
Dimension / hole minimum distance: 0.2 mm
Layout grid: 4 mil, part grid: 4 mil. Dimensions / hole positions: 0.5 mm
Board: FR4 black, 1.0 mm. Solder stop on vias < 0.6 mm.
Signoff rules: Footprint checked, pinmap checked, schematic checked, cross-references to other pages checked.
Routing: 1: general/escape 2: ground 3: horizontal 4: vertical 5: power 6: general/escape
Fiducials for machine vision alignment.
Parts: Resistors: 0402 / 1% unless specified otherwise Capacitors: 0402 to 1206, ceramic, voltage rating: 10V unless specified

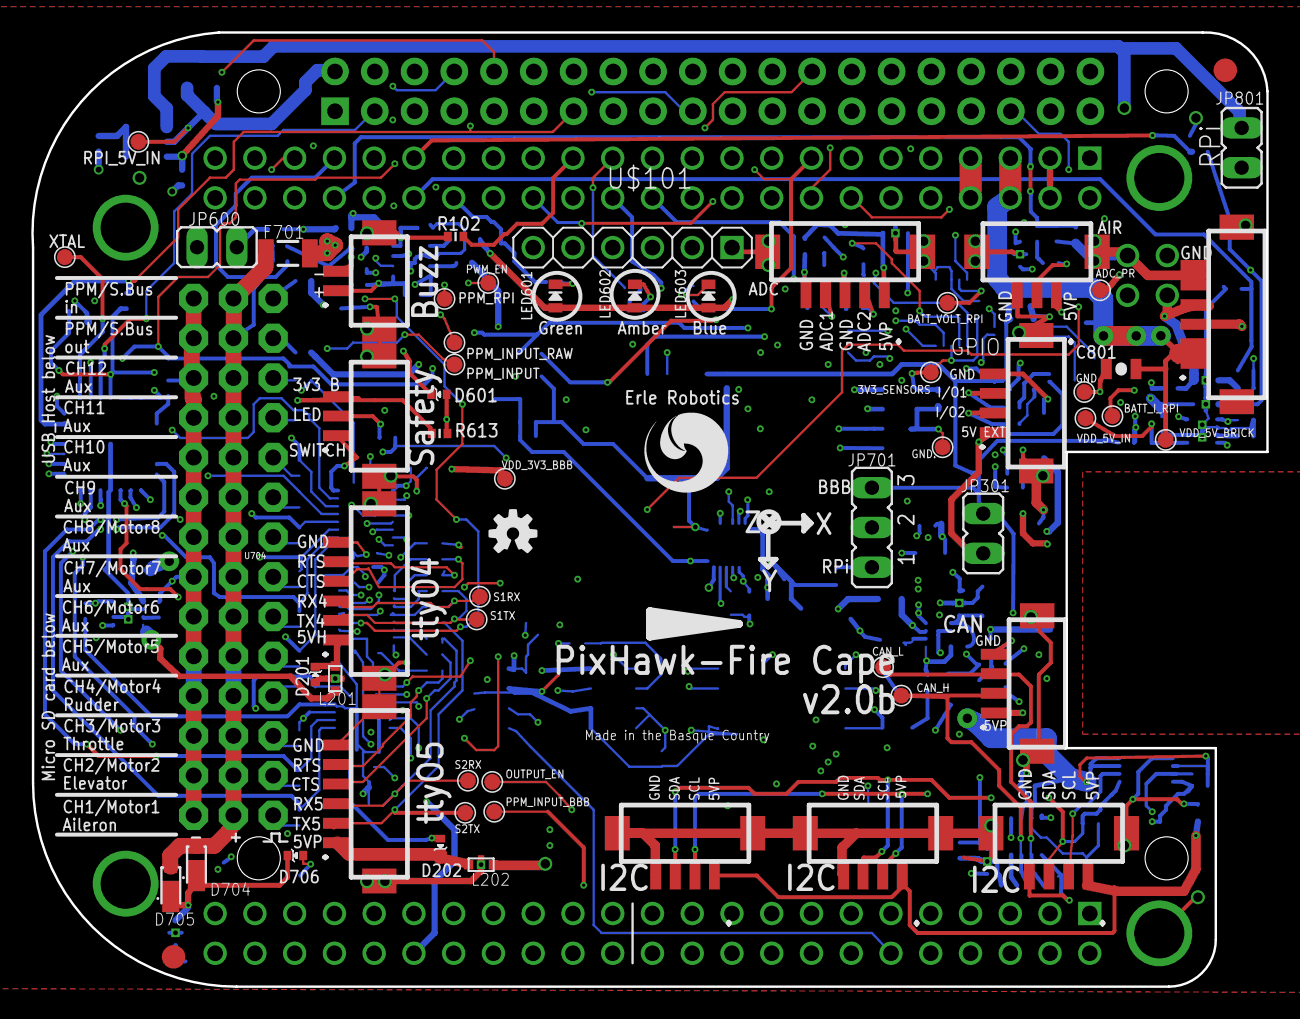
[picture p12: board PXF_v2.0.brd from above]

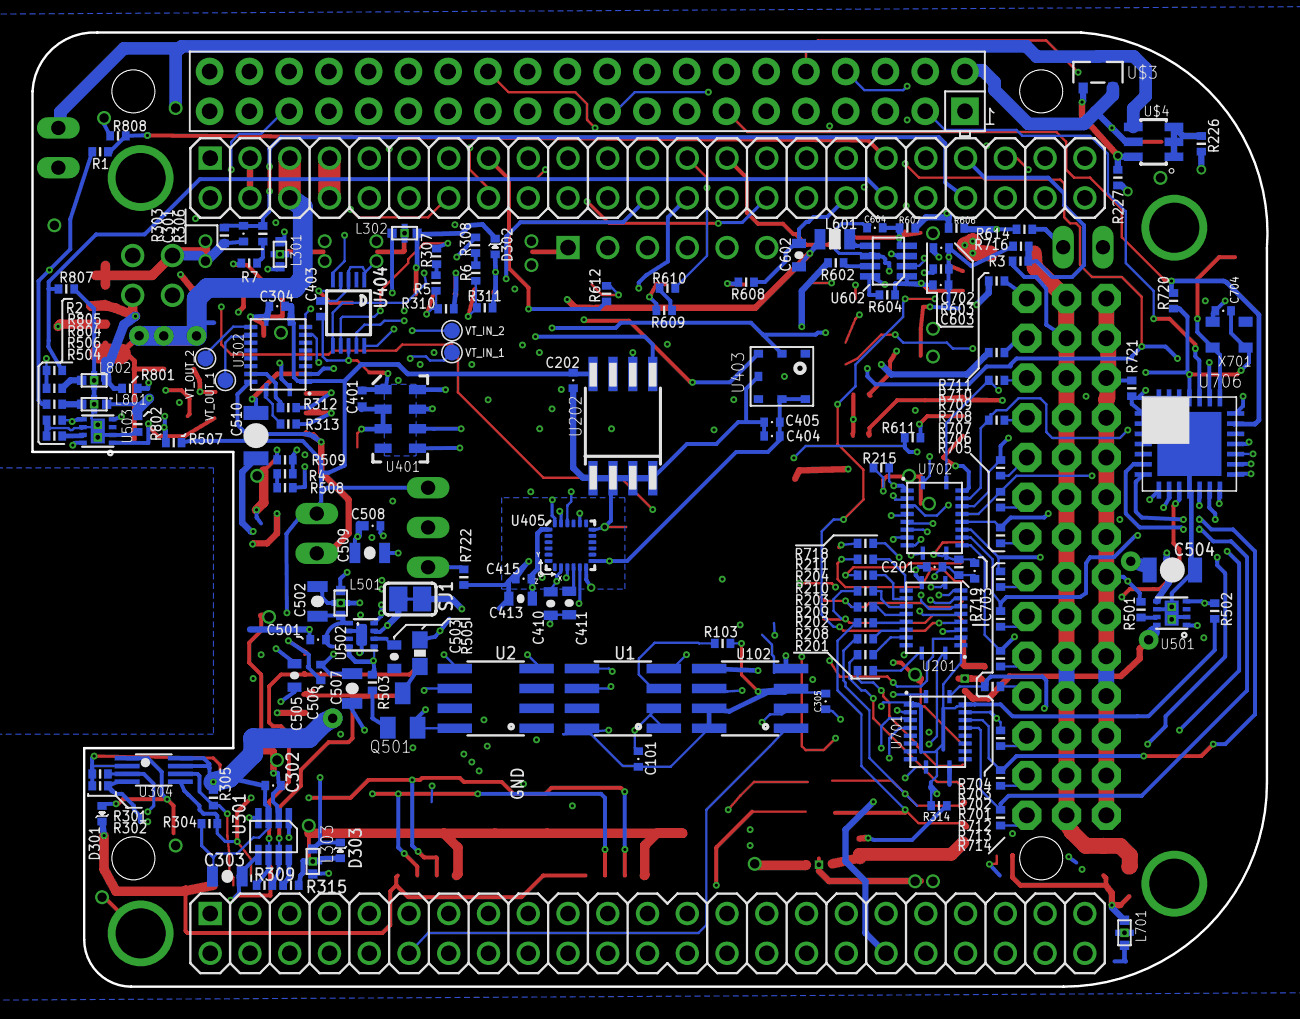
[picture p13: board PXF_v2.0.brd from below]

Board: 6 copper layers, 78.9 x 61.0 mm, 211 parts (151 on the bottom side), 166 nets.
