erlerobot/PXF2/Documentation/EAGLE-RasPi-BplusHAT/RasPi-BplusHAT.brd

## EAGLE design Documentation/EAGLE-RasPi-BplusHAT/RasPi-BplusHAT.brd (2015-11-10)

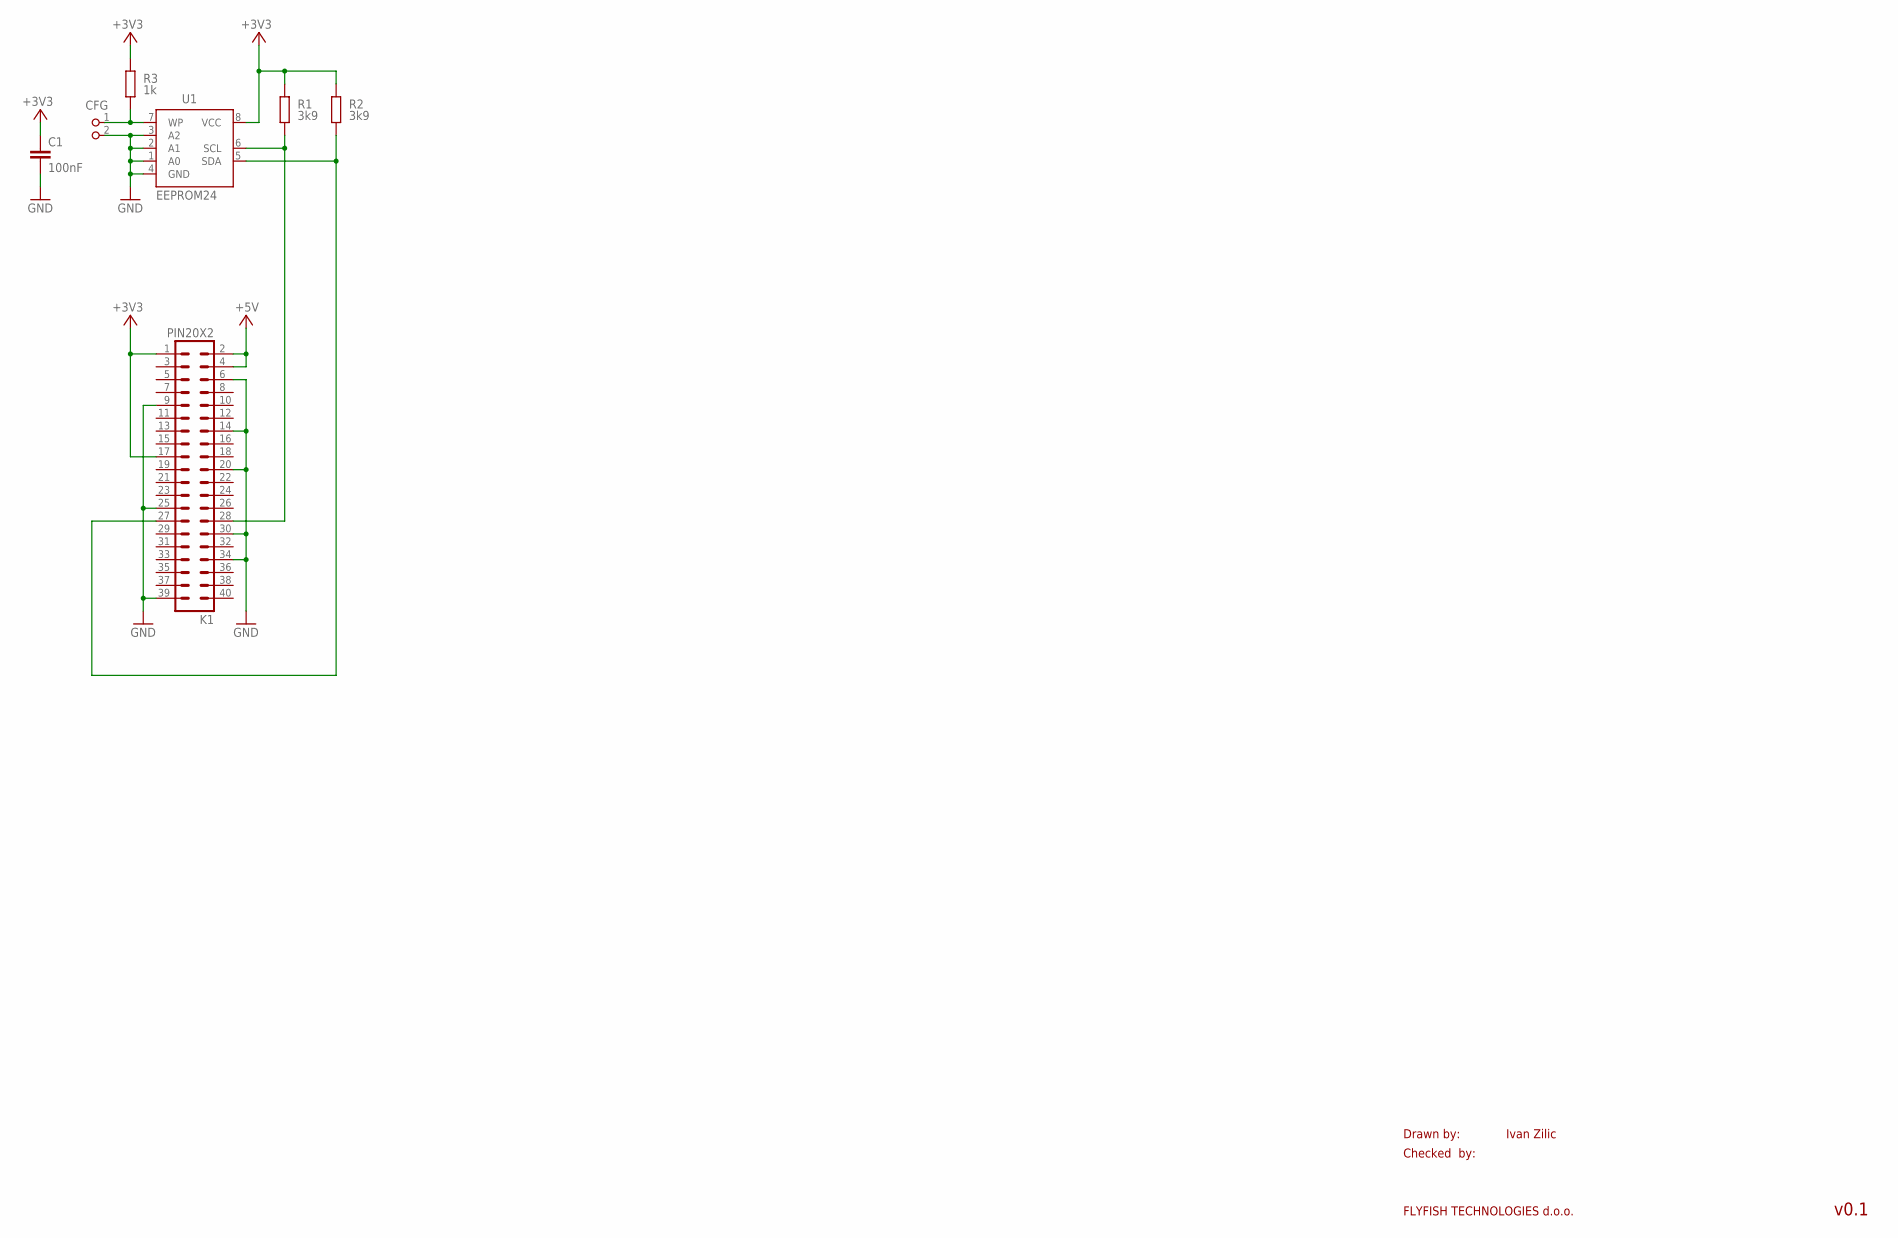
[picture p14: schematic RasPi-BplusHAT.sch]

Parts:
C1: 100nF; C0805K
CFG: PIN2_100; PIN_W_2
K1: PIN20X2; PIN_20X2
R1, R2: 3k9; M0805; TOLERANCE 5%
R3: 1k; M0805; TOLERANCE 5%
U1: EEPROM24; SOIC8

Connections:
+3V3: C1.1, K1.1, K1.17, R1.2, R2.2, R3.2, U1.8 (VCC)
+5V: K1.2, K1.4
GND: C1.2, CFG.2, K1.6, K1.9, K1.14, K1.20, K1.25, K1.30, K1.34, K1.39, U1.1 (A0), U1.2 (A1), U1.3 (A2), U1.4 (GND)
unnamed: K1.28, R1.1, U1.6 (SCL)
unnamed: K1.27, R2.1, U1.5 (SDA)
unnamed: CFG.1, R3.1, U1.7 (WP)

Notes on the sheet:
Drawn by:
Checked by:
FLYFISH TECHNOLOGIES d.o.o.
Ivan Zilic
v0.1

Board: 2 copper layers, 7 parts (0 on the bottom side), 6 nets, no tracks yet.
